vivekanandRdhakane/electrophy_2/ELECTROPHY_APP_AUDIT_AND_IMPLEMENTATION_PLAN.md

# Electrophy app audit and indexed implementation plan

Latest verification (6 November 2026): all 98 Android JVM tests passed and the debug APK was built. Following commit e5858c3 ("Keep paired Newton plot live across sample gaps"), the user verified on a Pixel 10 that 7,680 Hz dual-device streaming remains connected and responsive across packet gaps without pausing or disconnects. E003 remains partial (timing accuracy/drift and combined-mode acquisition timing remain open). Task E006 ("Repair comparator lag/correlation") completed with 8 acceptance tests in ComparatorTest.kt.

Reviewed: **11 October 2026**. Source baseline: repository commit `3262790` plus the files present during review. This is an audit and implementation specification, not a claim that the tasks below have been implemented.

## Verdict and scope

**The app is a useful prototype, but its measurements and all advertised scientific conclusions cannot currently be considered reliable.** There are confirmed data-integrity defects, a reproducible crash, incorrect numerical outputs, and physics labels that describe quantities the app does not actually measure. Fix acquisition and timekeeping before validating downstream experiment results.

Reviewed all seven application Kotlin files, all 16 experiment presets, Android permissions/build/test configuration, the firmware acquisition/command/packet paths, the bundled ST conversion driver, and relevant installed ESP-IDF v5.3.1 NimBLE source. The project context was read from `.agents/skills/electrophy/SKILL.md`. PCB electrical design was not audited.

Verification performed:

- Compiled the original `MathEngine.kt` with Kotlin 2.2.10 in a temporary JVM harness, with minimal stubs for Android-adjacent data types. Executed numerical probes of integration, FFT, STFT, statistics, autocorrelation, filter lab, and comparator; inspected derivative logic. This tests the actual engine source, not the complete Android app.
- Ran independent source-equivalent numerical checks for packet size, packing, high-g scaling, arrival-time distortion, notification counter behavior, vehicle integration, pendulum period ambiguity, free-fall triggering, and angle wrapping.
- Checked niche technical/physics claims against the primary references linked below.
- Attempted offline `:app:testDebugUnitTest :app:lintDebug :app:assembleDebug`. The first invocation could not create a Gradle cache lock under `C:\.gradle`; a retry using a writable workspace cache and installed Gradle/JDK stopped with `Error loading java.security file`. **No full Android build, lint, or test-suite pass is claimed.** The temporary workspace cache was removed.
- No Android runtime session, device flash, BLE hardware run, calibrated motion test, or throughput benchmark was performed. UX findings are from source inspection; actual layout and performance require device testing.
- Production app/firmware files were not changed. The existing modification to `workspace.code-workspace` was left alone. This document is the audit deliverable.

The skill is useful context but is not authoritative where it contradicts code or the sensor driver. In particular, its high-g sensitivity table is wrong, its CSV description overstates the current text export, and its flow-control description overstates the current implementation.

## How another AI agent should use this document

Example request:

> Implement E005 from `electrophy_2/ELECTROPHY_APP_AUDIT_AND_IMPLEMENTATION_PLAN.md`. Read its evidence, dependencies, implementation instructions, and acceptance tests. Implement only that task and necessary prerequisites. Run the relevant checks and update its status with the result.

Rules for the implementing agent:

1. Read the selected task and the shared contracts below. Read applicable repository instructions and the project skill. Re-check current source; line numbers describe this audit snapshot and will move.
2. Keep **E001–E041 stable**. Do not renumber tasks after completing or reprioritizing them. `E` IDs are distinct from the unrelated numbered ideas in `HIGH_IMPACT_FEATURES.md`.
3. Dependencies refer to completed behavior, not necessarily merged commits. If missing, report the prerequisite and implement the smallest authorized prerequisite or a clearly labeled interim fix. Never imply a downstream scientific feature is validated while its timing/acquisition prerequisites remain broken.
4. Preserve unrelated user changes. Avoid broad rewrites while fixing a local defect. Put numerical algorithms and protocol decoding into pure functions/classes where they can be tested without Compose or a BLE device.
5. App/firmware protocol changes must ship together, with a written version/layout specification and compatibility behavior. Do not silently reinterpret the existing format. An app-only deployment must identify unsupported/legacy firmware and explain unavailable measurements.
6. Add meaningful regression tests listed in the task. Do not replace real checks with tests of labels or a copy of the same faulty formula. Use known analytic signals or independently computed reference values.
7. Report exactly what was tested: JVM tests, Android build/lint, UI tests, firmware build, and physical measurements are different evidence. Never claim hardware accuracy from a passing unit test.
8. For each completed task, append a short record: status, changed files, tests/results, remaining limitations, and any follow-up IDs. Do not mark complete until its acceptance criteria are satisfied, or explicitly split an interim mitigation from final completion.
9. Keep scientific uncertainty visible: missing, stale, clipped, incomplete, and invalid results must not be represented as plausible zero values. Do not add precision or accuracy claims unsupported by measurement.
10. For ordinary verification use the project's wrapper from `Electrophy_app`: `./gradlew.bat :app:testDebugUnitTest :app:lintDebug :app:assembleDebug`. First establish a working compatible toolchain under E039. Read the ESP-IDF skill before firmware builds. No flashing is needed for most app-only fixes.

## Shared contracts and implementation order

These are design requirements, not a requirement to implement one large architecture rewrite:

- A measurement carries sensor identity, acquisition time, physical quantity/unit, applied configuration, calibration provenance, session/segment identity, and validity. Prefer integer microseconds or another documented monotonic tick unit internally; convert to plot-relative floating-point coordinates only for display.
- Keep acquired/raw data separate from calibrated and filtered data. Calibration and filtering must have explicit order and state reset rules. An experiment must say which representation it analyzes.
- Missing/off/stale sensors are absent/invalid, not zero. A repeated register value is not necessarily a new sample. Each sensor can have its own cadence.
- A capture is separate from a chart. A capture owns its boundaries, pre-event baseline, source axis/frame, parameters, and quality flags. Panning, decimation, and chart eviction must not alter saved measurement results.
- A device configuration has desired, pending, and applied states. Only applied settings describe a measurement. A rate change, reset, reconnect, or processing change must not silently mix incompatible data in one analysis.
- SI conventions: `1 g = 9.80665 m/s²`, `1 mg = 0.00980665 m/s²`, `1 mdps = 0.001 degree/s`. An accelerometer measures specific force; with a consistent body-to-world rotation, `a_world = R * f_body + g_world`. A stationary upward-facing accelerometer reads about +1 g while inertial acceleration is zero.

Recommended sequence: independently fix **E001, E005, E006** and establish **E039**; coordinate **E002–E004, E007–E010** as the acquisition/protocol foundation; then **E011–E022**; then the remaining P2 usability and interpretation work. Easy label corrections can be made early but do not count as complete scientific validation. E040 is optional expansion.

Priority meaning: **P0** silently corrupts foundational measurements; **P1** crashes, gives materially wrong results, or compromises capture reliability; **P2** completes interpretation, usability, or performance; **P3** optional expansion. P0 is a release priority here, not a claim of a safety-critical product.

## Task index

Model guidance checked **11 October 2026** for the stated **ChatGPT Plus and Google AI Pro** subscriptions. These are my engineering recommendations for the documented task scope, assuming prerequisites are complete; they are **not measured model benchmarks or guaranteed token savings**. Priority measures the consequence of a defect; complexity measures implementation difficulty. Thus E001 is P0 but still a small, well-specified fix.

**Model key:** **Luna** = GPT-6 Luna (`gpt-6-luna`); **Sol** = GPT-6.1 Sol (`gpt-6.1-sol`); **Astra** = GPT-6 Astra (`gpt-6-astra`). Use these in Work/Codex with repository and terminal access. OpenAI recommends Luna for focused tasks and Sol for complex coding at lower cost than Astra; availability depends on account/client rollout. If 6.1 Sol is absent, use the available GPT-6 Sol at the listed starting effort. [Official model guidance](https://learn.chatgpt.com/docs/models).

**Gemini key:** **Flash** and **Pro** mean the corresponding entries in the Gemini model picker, not the Google subscription name. The Gemini alternative is a substitute, not an instruction to run both providers. Google documents Low/Medium/High thinking controls; select them where exposed by your client. If your interface only offers a Pro/Thinking preset, use the corresponding available reasoning model rather than trying to set an unsupported API parameter. [Official Gemini model and thinking controls](https://support.google.com/gemini/answer/18648722?hl=en).

**Completion:** Use ✅ only when the task is fully implemented and its acceptance criteria are satisfied; otherwise leave the cell blank. Keep the task status and completion log in sync. Reconciled against source on **5 November 2026**, commit `2d5599d`: E001, E002, and E005 retain their recorded completion; E011 is partial (its earlier completion record overstates production integration). Several other tasks have partial implementations described below. Original evidence and numerical observations describe the October baseline unless explicitly updated.

| ID | Completed | Priority | Category | Task | Complexity | Recommended Codex model / effort | Gemini alternative / thinking |
|---|:---:|---|---|---|---|---|---|
| E001 | ✅ | P0 | Units | Correct high-g sensitivity conversion | Low | Luna / High | Flash / Medium |
| E002 | ✅ | P0 | Protocol | MTU-aware packets and strict decoding | High | Sol / High | Pro / High |
| E003 |  | P0 | Timing | Acquisition timestamps and explicit gaps | Very high | Astra / Medium | Pro / High |
| E004 |  | P0 | Acquisition | Fresh per-sensor samples and real synchronization | Very high | Astra / Medium | Pro / High |
| E005 | ✅ | P1 | Math | Fix median-filter crash | Low | Luna / High | Flash / Medium |
| E006 | ✅ | P1 | Math | Repair comparator lag/correlation | Medium | Sol / Medium | Pro / Medium |
| E007 | ✅ | P1 | Configuration | Atomic applied configuration and valid ODR modes | High | Sol / High | Pro / High |
| E008 | ✅ | P1 | Firmware | Propagate SPI/IMU errors | Medium | Sol / Medium | Pro / Medium |
| E009 |  | P1 | Transport | Correct flow control and loss accounting | High | Sol / High | Pro / High |
| E010 |  | P1 | Android | Reliable BLE lifecycle and operation completion | High | Sol / High | Pro / High |
| E011 |  | P1 | Capture | Separate captures, analysis intervals, and chart history | High | Sol / High | Pro / High |
| E012 |  | P1 | Math | Use actual time and align signals | High | Sol / High | Pro / High |
| E013 |  | P1 | Physics | Correct force, impulse, and SI quantities | High | Sol / High | Pro / High |
| E014 |  | P1 | Physics | Repair vehicle velocity-change experiment | Medium | Sol / Medium | Pro / Medium |
| E015 |  | P1 | Physics | Complete vector-based free-fall events | High | Sol / High | Pro / High |
| E016 |  | P1 | Physics | Measure pendulum swing period correctly | High | Sol / High | Pro / High |
| E017 |  | P1 | Attitude | Coordinate-consistent orientation estimator | Very high | Astra / High | Pro / High |
| E018 |  | P1 | Attitude | Correct plotted quantity and heading reset | Medium | Sol / Medium | Flash / Medium |
| E019 |  | P1 | Trigger | Typed trigger source and cancellable event lifecycle | High | Sol / High | Pro / High |
| E020 |  | P1 | Calibration | Validate and scope calibration | High | Sol / High | Pro / High |
| E021 |  | P1 | Recording | Reproducible structured recordings and reliable storage | High | Sol / High | Pro / High |
| E022 |  | P1 | Spectra | Correct FFT/STFT bins, amplitudes, and peak validity | High | Sol / High | Pro / High |
| E023 |  | P2 | Integration | Stable integral origins and honest detrending | Medium | Sol / Medium | Pro / Medium |
| E024 |  | P2 | Autocorrelation | Invariant period detection and useful lag range | Medium | Sol / Medium | Pro / Medium |
| E025 |  | P2 | Filters | Correct digital cutoff and response descriptions | Medium | Sol / Medium | Pro / Medium |
| E026 |  | P2 | Statistics | Correct statistical labels and plots | Medium | Sol / Medium | Pro / Medium |
| E027 |  | P2 | Derivative | Source-aware derivatives and accurate stencil labels | Medium | Sol / Medium | Pro / Medium |
| E028 |  | P2 | Physics | Correct the Newton's Third Law claim | Low | Luna / High | Flash / Low |
| E029 |  | P2 | Physics | Complete centripetal analysis | Medium | Sol / Medium | Pro / Medium |
| E030 |  | P2 | Physics | Complete elevator interpretation | Medium | Sol / Medium | Pro / Medium |
| E031 |  | P2 | Attitude UX | Remove unsupported flight/compass claims | Low–medium | Luna / High | Flash / Medium |
| E032 |  | P2 | Precision | Explicit transport resolution and range policy | High | Sol / High | Pro / High |
| E033 |  | P2 | Performance | Shared background analysis and bounded rendering | High | Sol / High | Pro / High |
| E034 |  | P2 | Charts | Trustworthy sample cursors and interval inspection | Medium | Sol / Medium | Flash / Medium |
| E035 |  | P2 | Navigation | Preserve experiment state and handle system Back | Medium | Sol / Medium | Pro / Medium |
| E036 |  | P2 | Connection UX | Device selection, recovery, and live diagnostics | Medium | Sol / Medium | Pro / Medium |
| E037 |  | P2 | Math UX | Inspectable FFT, spectrogram, and XY plots | Medium | Sol / Medium | Flash / Medium |
| E038 |  | P2 | Accessibility | Responsive controls and accessible plots | Medium | Sol / Medium | Flash / Medium |
| E039 |  | P1 | Validation | Reproducible build and scientific regression suite | High | Sol / High | Pro / High |
| E040 |  | P3 | Expansion | Saved-run browser and offline replay | Medium | Sol / Medium | Pro / Medium |
| E041 |  | P2 | Experiment UX | Guided setup, run, review, and quality feedback | Medium | Sol / Medium | Flash / Medium |

### Using the recommendations economically

- **Choose one provider per implementation.** Prefer the environment that can read the repository, edit files, and run the required tests. If using Gemini chat without those tools, provide only the relevant files and request a patch; apply and test it locally. A subscription/model name alone does not establish local execution access. Gemini model/feature availability remains subject to the plan and current limits. [Google AI plan limits](https://support.google.com/gemini/answer/16275805).
- **Do not default to Ultra for one task.** Start at the table's effort. OpenAI's controls differ by model: Luna High is a normal economical starting point, not equivalent in cost to Astra High. Max/Ultra are escalation options rather than this plan's defaults. [Reasoning-effort guidance](https://learn.chatgpt.com/docs/models).
- **Use smaller scope before more effort.** For E003/E004/E017, ask the recommended model to establish the protocol/estimator contract and tests first, then implement bounded pieces against that contract. Once settled, mechanical follow-up edits can use Sol or Luna. E039 should be split into toolchain setup, regression fixtures, and hardware qualification; no model replaces the physical checks.
- **Escalate based on evidence.** If a focused attempt plus one correction still fails a meaningful test or keeps changing its design, hand off the failing test, current diff, and short decision summary. Escalate Luna to Sol, Sol Medium to High, or unresolved Sol High architecture work to Astra Medium/High. For Gemini, escalate Flash to Pro or Medium to High. Do not keep retrying a weak approach just because its individual calls are smaller.
- **Spend a stronger review only where it matters.** After timing/acquisition/configuration work is integrated, a focused review of the shared interfaces, failure paths, and tests is more useful than re-auditing this entire document after each label edit. A successful model review does not replace the acceptance tests.
- **Read only the selected task and its dependencies.** Ask the agent to locate `### E___`, read the shared contracts and relevant source symbols, and avoid loading all 41 task bodies. Keep a short implementation handoff recording decisions, changed files, and test results. Request a concise final report, not a regenerated audit.
- **Scope qualifications:** E014 assumes the fixed-mount baseline path and completed data prerequisites; a new general 3D velocity estimator needs a separate High-effort design. E027 assumes accurate labeling of the existing derivative; adding a new validated derivative algorithm merits Sol/Pro High. E028 covers the single-sensor correction, not dual-device support. E031's inexpensive path labels the existing body-Z rate honestly and consumes existing quality state; new heading-rate mathematics or freshness infrastructure belongs to its prerequisite tasks.
- **Optimize allowance, not just visible response length.** Context, reasoning, tools, and retries affect usage; API token prices are not subscription task quotas. Use Standard speed when minimizing credit spend and check the usage dashboard rather than assuming a fixed number of tasks. No percentage saving is promised. [OpenAI subscription and credit guidance](https://learn.chatgpt.com/docs/pricing).

Suggested economical prompt:

> Implement E005 from `ELECTROPHY_APP_AUDIT_AND_IMPLEMENTATION_PLAN.md`. Read only its task body, the shared contracts, applicable repository instructions, and necessary source/dependency sections. Keep the change focused; preserve unrelated edits. Run its acceptance tests and report the changed files, actual results, and remaining limitations concisely. Do not implement other task IDs unless an essential prerequisite is identified and its scope is made explicit.

## Feature-by-feature coverage

All features depend on valid acquisition; a sound formula alone does not validate the end-to-end result.

| Existing feature | Assessment | Main tasks |
|---|---|---|
| Raw LOW/HIGH/BOTH/GYRO/ALL streaming | Packing sign convention is sound; timing, MTU, stale channels, ALL meaning, and error handling are not | E001–E004, E007–E010, E036 |
| ODR/range controls | Useful configuration coverage; displayed values can differ from hardware; 1.875 Hz request is rejected in current sensor mode | E007 |
| Pause/resume/clear | Basic actions exist; session time, callbacks, capture boundaries, and state resets are inconsistent | E003, E010, E011, E019, E035 |
| Calibration | Single-position mean subtraction is limited but useful; no motion/quality validation or device scope | E020 |
| EMA and auto-trigger | EMA recurrence is sound; cutoff label, unit mixing, and delayed trigger lifecycle need repair | E019, E025 |
| Recording/export | Records text, not reproducible timestamped CSV; charts and exports use different calibration states | E021 |
| Raw/physics charts and cursors | Useful live plots; live cursor can be an arbitrary coordinate and two cursors can refer to different axes | E011, E034, E038 |
| 3D Aeroplane Attitude | Static signs match renderer; dynamic estimation, heading claims, and degree plot are flawed | E017, E018, E031, E032 |
| Simple Pendulum | Computes Z-signal period, which can be half the actual swing period | E016 |
| Vehicle Acceleration | Uses the wrong sensor ODR, wrong units, and an unspecified frame | E014 |
| Newton's Third Law | Single-object acceleration is not an action–reaction measurement | E013, E028 |
| Free Fall | Magnitude-based helper is conceptually correct; trigger and event completeness are not | E015, E019 |
| Centripetal Acceleration | Generic peaks do not implement the advertised quantitative comparison | E029 |
| Impulse & Momentum | Integral lacks mass/SI conversion and an explicit event/baseline | E011, E013 |
| Elevator Physics | Useful qualitative trace with fixed upward mounting; interpretation and load results incomplete | E030 |
| Numerical Integration | Uniform-sample trapezoidal algorithm is sound; timebase, origin, and detrending semantics need work | E012, E023 |
| Numerical Derivative | Valid two-point central difference, not the implied higher-order stencil | E012, E027 |
| FFT Frequency Spectrum | FFT core and main window gain correction are sound; Nyquist and peak validity are wrong | E012, E022, E037 |
| Spectrogram | Windowed overlapping FFT approach is sound; scaling, axes, and recomputation need work | E022, E033, E037 |
| Statistics & Distribution | Population moments are sound on nonconstant data; labels/undefined values/plot scales need work | E026 |
| Autocorrelation | Biased normalized estimator is legitimate; detector depends on display scaling and lag range is short | E024 |
| Digital Filter Lab | Several correct basic recurrences; selecting median with default size crashes | E005, E025 |
| Signal Comparator | Pearson is correct only for aligned nonconstant data; lag search is broken and streams are not aligned | E006, E012 |
| Experiment catalog/navigation | All 16 presets are discoverable; state restoration, connection access, setup flow, and accessibility need work | E035–E038, E041 |

## Evidence reference paths

To keep tasks economical for smaller models, use these aliases. All paths are relative to `electrophy_2`:

- **MAIN**: `Electrophy_app/app/src/main/java/com/example/electrophy_app/MainActivity.kt`
- **EXP**: same directory, `ExperimentScreen.kt`
- **MODES**: same directory, `ExperimentModes.kt`
- **MATH**: same directory, `MathEngine.kt`
- **MATHUI**: same directory, `MathVisualization.kt`
- **AIR**: same directory, `Airplane3DView.kt`
- **PICKER**: same directory, `ExperimentPickerScreen.kt`
- **FW**: `esp_sensor/main/main.c`
- **ST**: `esp_sensor/main/lsm6dsv320x_reg.c`

## P0 — Measurement integrity

### E001 — Correct high-g sensitivity conversion

**Status:** [x] Complete. **Scope:** app conversion and documentation. **Dependencies:** none.

**Evidence:** MAIN:923–929 uses `0.009765 g/LSB` at ±320 g. ST:86–108 specifies `10.417 mg/LSB`, or `0.010417 g/LSB`. This underreports by about **6.259%**. The 64/128/256 g entries also differ slightly from the official driver. The project skill repeats these errors.

**Implement:** Centralize conversion by sensor/range/format. Use high-g g/LSB factors `[0.000976, 0.001952, 0.003904, 0.007808, 0.010417]`. Preserve the legacy packed12 multiplier of 16. Reject unknown range IDs. Correct the skill's table and any duplicate factors. Do not replace correct low-g/gyro factors using a guessed full-scale/32768 formula; use the manufacturer's sensitivities. [ST driver](https://github.com/STMicroelectronics/lsm6dsv320x-pid/blob/master/lsm6dsv320x_reg.c).

**Acceptance:** Packed value 600 at high-g FS code 4 becomes **100.0032 g**, not 93.744 g. Verify positive/negative/boundary values for every scale and both legacy formats against the bundled driver. Threshold display, export, and analysis must share the same conversion.

### E002 — MTU-aware packets and strict decoding

**Status:** [x] Complete. **Scope:** app + firmware. **Dependencies:** coordinate packet layout with E003/E004.

**Evidence:** FW:896–898 batches against a fixed 512-byte buffer; FW:1009–1011 only logs MTU. Full notifications can contain 509 value bytes and need ATT MTU ≥512. The installed NimBLE path (`ble_att_cmd.c:74`, `ble_att.c:408–411`) truncates oversized ATT payloads. At MTU 247, a low-g packet can still declare 111 samples but contain only 52 complete tuples. MAIN:225–226 returns zero after bit exhaustion, manufacturing apparent zero-g samples. MAIN:913 treats every unknown format as raw16; range IDs default silently.

**Implement:** Size values to `min(buffer_capacity, negotiated_ATT_MTU - 3)`. Define behavior when a full tuple plus header cannot fit; do not silently send truncated ALL tuples at MTU 23. Validate the entire frame before changing state: magic/version, allowed mode/format/ranges, sample count, and required payload bytes (`ceil(count*axes*bits/8)` plus header for the legacy layout). Explicitly define allowed padding. Make bit-reader exhaustion an error. Never feed invalid frames to calibration, triggers, timekeeping, charts, or recording. Bound text fallback accumulation; malformed binary must not become an unbounded text buffer.

**Acceptance:** All modes at MTUs 23/185/247/517, odd packed sample counts, every truncation boundary, invalid headers/IDs, and random input. No invalid input emits a sample or starts free fall. Every transmitted value fits its link capacity. Add paired firmware encoder/app decoder fixtures.

### E003 — Acquisition timestamps and explicit gaps

**Status:** [ ] Partial — v2 single-sensor FIFO timeline, counters, segments, gap handling, and overhead diagnostics implemented 5 November 2026. In-segment sample gaps are explicitly counted in diagnostics while keeping live plots and paired capture running across loss (commit `e5858c3`). Hardware timing/rate qualification and combined-mode acquisition timing remain open; see the E003 log and `esp_sensor/TIMING_PROTOCOL.md`. **Scope:** app + firmware protocol. **Dependencies:** coordinate E002/E004/E007; required by quantitative analysis.

**Evidence:** FW:127–137 has no acquisition timestamps or sample counters. MAIN:949–953 spreads samples between phone wall-clock notification times and invents +20 ms when callbacks coalesce. MAIN:908 reads but ignores sequence. MAIN:1145–1155 independently uses receipt timing for attitude. Reconnect resets the time origin without clearing chart data; resume spreads a batch across the pause.

**Implement:** Write a versioned packet specification with session/segment and configuration IDs, acquisition timestamp information, per-sensor sample counters, and validity/loss metadata. Prefer verified sensor FIFO/timestamp information; a device monotonic read timestamp needs its acquisition uncertainty documented. Define wrapping and reset behavior. Store monotonic time in `Long`/`Double`, preserving true gaps. Keep phone receipt times for transport-arrival diagnostics; absolute one-way latency additionally requires a device-to-phone clock mapping. Reset/segment on pause, reconnect, and configuration changes; never mix old/new zero-based timelines. Legacy timing must be labeled estimated and unsuitable for claims that require precision.

**Acceptance:** The same acquired samples delivered with different BLE jitter, same-millisecond bursts, and batching have identical retained timestamps and valid-interval results. Dropped samples leave explicit gaps. Phone clock changes do not alter measurements. Cover counter/timestamp wrap, pause/resume, reconnect, and long runs. No subsequent packet is stretched over a missing interval.

### E004 — Fresh per-sensor samples and real synchronization

**Status:** [ ] TODO. **Scope:** firmware acquisition and app sample model. **Dependencies:** E003, E008; coordinate E007/E009.

**Evidence:** FW:241–259 routes only the fastest selected DRDY. FW:1249 discards the returned notification count. FW:1254–1265 reads every selected channel on every wakeup, without confirming per-sensor freshness, ODR-off state, or read success. ALL at low/gyro 120 Hz and high-g 480 Hz can publish repeated low/gyro registers as 480 fresh tuples/s. Timeout wakeups and collapsed interrupts further obscure sample identity.

**Implement:** Use the part's tagged FIFO with verified configuration/timing, or read each sensor only when its data-ready state confirms a fresh sample and provide its own counter/time. Never represent an off sensor with stale values. Explicitly account for overruns/missed DRDY and rejected reads. Synchronization/resampling belongs in a declared downstream operation. Define what ALL means: the current app sometimes means accel+gyro while the wire layout includes high-g. Make source availability explicit across protocol, raw UI, and math selection.

**Acceptance:** At 120/480/120 Hz, unique per-sensor counts reflect each actual cadence. An off channel emits no valid samples. Timeout/configuration wakeups and injected SPI failures create no fake data. Validate high-rate counts and loss with FIFO counters/logic-analyzer evidence before claiming 7.68 kHz fidelity. Merely obtaining 7680 repeated values is not a pass.

## P1 — Incorrect results, crashes, and unreliable captures

### E005 — Fix median-filter crash

**Status:** [x] Complete. **Scope:** math engine + control. **Dependencies:** none.

**Evidence:** MATH:680–695 allocates `FloatArray(w)` but fills `2*(w/2)+1` interior entries. MATHUI:68 defaults to window **12**. Selecting MEDIAN with ordinary data throws `ArrayIndexOutOfBoundsException: Index 12 out of bounds for length 12` in an actual compiled-engine probe.

**Implement:** Define centered odd window sizes, normalize public engine input safely, and make the UI show the effective odd size. Deliberately handle clipped edge windows; if their population is even, specify whether the median averages the two center values. Do not just enlarge one array while leaving contradictory window labels.

**Acceptance:** Every selectable/default size, even requested sizes, short/empty input, larger-than-input windows, constants, ramps, and isolated impulses. No crash; expected medians and effective-size labels agree.

### E006 — Repair comparator lag/correlation

**Status:** [x] Complete. **Scope:** math engine/results. **Dependencies:** local algebra fix independent; final cross-sensor correctness needs E012.

**Evidence:** MATH:753–797 initializes `bestCorr=-2`, then only updates when `abs(c)>abs(bestCorr)`. Normal inputs cannot satisfy this, so lag remains zero and the clamped peak becomes −1. Actual identical sine probe: Pearson=1, peak=−1. A 10 Hz sine delayed six samples at 240 Hz produces lag=0 instead of 25 ms.

**Implement:** Correct initialization and choose/document positive-similarity versus absolute-similarity search. Preserve polarity. Normalize using the actual overlap or another documented bounded estimator; do not conceal incorrect normalization by clamping. Define delay sign in user language. Return unavailable for constant/insufficient signals. Report phase only for a justified common periodic component, not every arbitrary waveform.

**Acceptance:** Identical, inverted, constant, noisy, and positive/negative delayed deterministic broadband signals; edge overlaps; periodic examples with a stated ambiguity convention. For a nonperiodic B delayed 25 ms, report that B lags A by 25 ms within one-sample/interpolation tolerance. Aligned Pearson remains correct.

### E007 — Atomic applied configuration and valid ODR modes

**Status:** [x] Complete. **Scope:** firmware + app applied-state UI. **Dependencies:** E008; coordinate E002–E004/E010.

**Evidence:** FW:504–732 mutates hardware and shared batch state from the BLE callback while the sensor task uses them. A partly filled batch can be labeled with a newly selected scale at FW:865–869. The SPI mutex does not make a whole configuration transaction atomic. Driver returns are ignored. FW:545–547 requests 1.875 Hz with unchanged high-performance mode; ST:629–637 rejects that combination, but firmware claims it succeeded. MAIN:1318 resumes before sending the rest of the configuration.

**Implement:** Have one acquisition owner consume validated configuration requests. Finish/discard a batch using its old metadata, apply a complete configuration with driver return checks/readback and required settling, increment configuration ID, acknowledge actual settings, then restore the requested running/paused state. Changing a range while paused must not restart capture. Separate desired/pending/applied settings. Make invalid/unsupported commands explicit errors. Select the documented low-power mode for 1.875 Hz or remove that option until supported; restore appropriate modes at higher rates. A GATT write acknowledgement alone is not confirmation that the IMU accepted the configuration. [ST datasheet](https://www.st.com/resource/en/datasheet/lsm6dsv320x.pdf).

**Acceptance:** Rapid range/mode changes cannot create mixed-scale or mixed-layout batches. Driver failures and invalid commands leave a clear failed/pending state rather than false success. Verify 1.875 Hz by register state and measured cadence. Capture metadata matches the applied configuration, even during reconnect/preset changes.

### E008 — Propagate SPI/IMU errors

**Status:** [x] Complete. **Scope:** firmware readiness/error path. **Dependencies:** none.

**Evidence:** FW:347–370 discards SPI write errors and returns success. FW:382–413 discards read errors, can copy uninitialized receive data on failure, and silently clamps oversized reads. Initialization/acquisition commonly ignore driver results.

**Implement:** Propagate transport failure; release CS/mutex on every path; reject invalid lengths. Only publish fully successful measurements. Check sensor identity/configuration/readiness, expose fault counters/status, and define bounded recovery. Do not report a ready measurement device when sensor initialization failed.

**Acceptance:** Inject failures in every transaction stage, missing/wrong WHO_AM_I, oversized reads, and repeated read failure. No arbitrary values reach a packet. Resources are released and recovery/failure status is deterministic.

### E009 — Correct flow control and loss accounting

**Status:** [ ] TODO. **Scope:** firmware transport + app diagnostics. **Dependencies:** E003/E004.

**Evidence:** FW:810–816 increments `s_notify_in_flight` after `ble_gatts_notify_custom`; FW:1013–1016 decrements in `BLE_GAP_EVENT_NOTIFY_TX`. Installed IDF 5.3.1 NimBLE `ble_gattc.c:4468–4473` dispatches that event synchronously before returning, for a transmission attempt. Sequential success therefore leaves the count around one, not the claimed queue occupancy. Some dropped batches never advance sequence; app ignores sequence anyway.

**Implement:** Use a bounded acquisition-to-transport queue, explicit overflow policy, actual return-code handling, and pacing based on verified SDK semantics. Do not call notification-attempt callbacks over-air or application delivery acknowledgements. If reliable capture delivery is required, design application credits/acknowledgements or capture-then-transfer. Count all acquisition/queue/transport losses using sample identity, independently of successful packet numbering. Expose configured, acquired, and received rates separately.

Report exact loss counts where observable and explicitly unknown counts for sensor/FIFO overruns where they cannot be recovered. A counter assigned after reading registers cannot alone count unread sensor conversions.

**Acceptance:** Callback-before-return mock, allocation failures, 1M PHY, insufficient throughput, slow receiver, and disconnect during transmit. Memory remains bounded, acquisition remains responsive, no deadlock, and loss totals reconcile with sample counters.

### E010 — Reliable BLE lifecycle and operation completion

**Status:** [ ] TODO. **Scope:** Android connection owner. **Dependencies:** coordinate E007/E003.

**Evidence:** MAIN:829 declares Connected before successful CCCD completion and without requiring every characteristic. MAIN:840–855 ignores write status. MAIN:729–733/1565 treats a 250 ms timeout as completion; a late callback can advance the wrong later operation. Service discovery depends on `onMtuChanged` even when `requestMtu` fails immediately. `connectToDevice` does not retain the returned GATT until a connection callback; cancellation while connecting is incomplete. No `onCleared` cleanup or connection-generation guard exists.

**Implement:** Model scanning/connecting/discovering/subscribing/configuring/ready/error. Serialize relevant GATT operations with retained identity; check immediate start and callback status, handle fallback and bounded timeout/retry, and reconnect cleanly when state is unknown. Reject old-session callbacks and close the exact GATT instance. Retain the `BluetoothGatt` object returned by `connectGatt` immediately. Cancel scans/handlers/retries on disconnect/owner cleanup. Choose and document foreground-only capture or a properly implemented background recording service. Follow [Android BluetoothGatt contracts](https://developer.android.com/reference/android/bluetooth/BluetoothGatt).

**Acceptance:** Failed/missing CCCD, missing RX/TX, MTU-start failure, late/failed writes, scan error, connection timeout, cancellation while connecting, old disconnect callbacks after reconnect, activity rotation and final owner disposal. Never show Ready without an operational subscription/applied configuration. No leaked callbacks or GATT objects.

### E011 — Separate captures, analysis intervals, and chart history

**Status:** [ ] Partial — chart history/decimation and capture model implemented; production capture ownership and quality feedback remain incomplete (5 November 2026 review). **Scope:** data/capture model + shared chart selection. **Dependencies:** E003/E004; coordinate E019/E021.

**Evidence:** MAIN:102/1129–1133 retains 1500 points. This is about 0.195 s at 7680 Hz, 0.391 s at 3840 Hz, 3.125 s at 480 Hz, and 12.5 s at 120 Hz. Several presets request much longer windows. EXP:399–405 analyzes the entire retained list while its chart independently selects a viewport. EXP:1605/1643 re-estimates baseline from whichever first ten samples remain. Results change when old data is evicted. Promised impulse shading is absent.

**Implement:** Introduce explicit captures with start/trigger/end, fixed pre-event baseline, source/frame, applied config/calibration, and quality flags. Use a bounded duration-aware full-rate acquisition/analysis buffer distinct from plot decimation. Lift selected interval/axis above chart and analysis; feed both the same slice and draw integral/event shading. Freeze finished captures. Define supported maximum duration/rate and storage strategy rather than retaining unbounded data.

**Acceptance:** Every supported preset duration is actually available. Saved integrals remain unchanged while the live chart scrolls. Selecting either of two pulses changes shading/results together. Missing pre-trigger baseline, clipping, gap, and incomplete endpoint are visible. Chart point eviction cannot alter a captured result.

### E012 — Use actual time and align signals before math

**Status:** [ ] TODO. **Scope:** shared math input preparation. **Dependencies:** E003/E004/E011.

**Evidence:** MATH:161/201/245/415/540/714–720 uses selected ODR. Comparator pairs equal-length tails by index with no time alignment; EXP:150–155 uses only source A's ODR and coerces off to 1 Hz. Actual engine probe: constant 1 at `[0,10,30] ms` integrates to 0.02 using 100 Hz, versus 0.03 for valid irregular timestamp integration.

**Implement:** Distinguish valid irregular sampling from missing measurements. Use actual valid intervals for calculus; segment or reject gaps rather than inventing missing values. FFT/STFT/autocorrelation require a verified uniform contiguous segment or explicit validated resampling. Align comparator streams on a common time interval/grid, with anti-aliasing before downsampling. Reject duplicate/reversed time, unavailable sources, and invalid rates. Changes in rate/configuration/processing must not retroactively reinterpret old points.

**Acceptance:** Known irregular samples, explicit missing intervals, unequal-rate streams, offset starts, no overlap, ODR changes, and duplicate/reordered timestamps. A valid irregular `[0,10,30] ms` constant record integrates to 0.03; a declared loss spanning that interval is flagged according to policy. Known frequencies and delays remain correct or produce a clear unavailable result.

### E013 — Correct force, impulse, and SI quantities

**Status:** [ ] TODO. **Scope:** collision/impulse/peak analyses and quantity metadata. **Dependencies:** E001/E011/E012/E020.

**Evidence:** EXP:424–433 labels accelerometer g/mg values “Peak Force” and g·s as `∫F·dt`. EXP:1602–1612 integrates baseline-subtracted Z without mass or SI conversion. MODES:111–130/172–191 promises force, impulse, and `Δv=J/m`, but there is no mass input.

**Implement:** First correct the labels to peak specific force/acceleration and acceleration integral. For force/impulse, require positive finite mass in kg and an explicit physical model. A fixed horizontal axis along motion is a useful initial supported setup: after appropriate baseline/external-force assumptions, report `F=m*a`, `J=∫F dt`, and `Δv=∫a dt` in N, N·s, and m/s. Mass alone does not isolate a particular contact force from other forces. For general orientation, use the documented gravity/frame transformation. Retain raw g/mg as a clearly separate display. Use timestamped trapezoids over the selected capture interval, with a fixed baseline. [BIPM standard gravity](https://jcgm.bipm.org/vim/en/2.12.html), [NXP specific-force/tilt discussion](https://www.nxp.com/docs/en/application-note/AN3461.pdf).

**Acceptance:** A horizontal acceleration pulse with integral 2 m/s and mass 0.5 kg gives impulse 1 N·s. Doubling mass doubles force/impulse and leaves Δv unchanged. Equivalent low/high-g inputs give equal SI results. Missing/invalid mass leaves force unavailable. Stationary baseline-relative data yields zero integral. Do not convert an existing wrong number merely by changing its label.

### E014 — Repair vehicle velocity-change experiment

**Status:** [ ] TODO. **Scope:** vehicle preset, setup, integration. **Dependencies:** E011–E013/E020; dynamic-orientation option also needs E017.

**Evidence:** EXP:446–449 chooses `highGOdr ?: lowGOdr`, but highGOdr is non-null, even for low-g data. With low-g 120 Hz and high-g 480 Hz, integration is one quarter of its intended scale; a retained high-g `off` instead hits a 100 Hz fallback. Output is labeled `units/s` although an integral multiplies by time. MODES:92–106 selects Z without forward-axis setup and arms a 3 g deviation trigger.

**Implement:** Consume actual low-g timestamps, eliminate duplicated string/rate parsing, and report Δv in m/s. Add forward axis/sign, stationary pre-run baseline, explicit start/stop/reset, and a fixed-orientation mounting contract. Flag motion outside that model; a baseline does not remove gravity when the board rotates. A general moving-orientation option requires synchronized gyro, gravity correction, and drift handling. Remove the ordinary-driving 3 g auto-stop default; retain deliberate spike capture as a separate choice. Do not label Δv as absolute speed without initial velocity.

Low-g alone cannot reliably distinguish tilt from linear acceleration. Fixed mounting is a declared user assumption; any claimed automatic rotation check requires synchronized gyro and stated detection limits. If that check is not implemented, show the limitation and do not claim automatic rejection of tilted runs.

**Acceptance:** A baseline-corrected +1000 mg plateau with endpoints 1 s apart integrates to 9.80665 m/s, independently of retained high-g settings or prior experiments. Stationary data gives zero. Rotating a stationary board is corrected or visibly unsupported, not plausible vehicle acceleration. Re-run starts a new baseline/origin.

### E015 — Complete vector-based free-fall events

**Status:** [ ] TODO. **Scope:** shared trigger/duration detector. **Dependencies:** E002/E003/E011/E019/E020.

**Evidence:** MODES:142–148 triggers on `Z <= 100 mg` and pauses 500 ms later, but EXP:1653–1674 measures `|a| < 200 mg`. A stationary side-on board `[1000,0,0] mg` triggers despite not falling. The helper reports the longest retained low-g interval without requiring a complete start/end; a fall exceeding the delay can be presented as a completed truncated fall.

**Implement:** Use one calibrated specific-force magnitude detector for arming, triggering, and analysis. Define hysteresis, minimum duration, stationary/armed state, return/contact completion, and a maximum timeout that yields incomplete status. Use acquisition timestamps and justified threshold-crossing interpolation. Reject intervals spanning gaps/missing endpoints. Analyze acquisition data with documented filter-delay behavior. Explain near-zero accelerometer output as weightlessness/near-zero specific force, not absence of gravitational acceleration.

**Acceptance:** No stationary orientation at magnitude 1 g triggers. A complete 100 ms zero-g interval is measured within stated sampling tolerance. An 800 ms event is not silently cut to 500 ms. A low-g event at the capture boundary is in progress/incomplete. Gaps and invalid packets cannot create free fall.

### E016 — Measure pendulum swing period correctly

**Status:** [ ] TODO. **Scope:** pendulum signal/setup/estimator. **Dependencies:** E003/E011/E012.

**Evidence:** MODES:74–84 uses low-g only and suggests `T=2π√(L/g)` without a mounting model. EXP:1615–1637 finds upward mean crossings of Z. A co-rotating radial accelerometer contains `g*cos(theta) + L*thetaDot²`, terms that can repeat twice per swing. A reproduced `theta=0.2*cos(πt)` model with a 2 s swing yields a 1 s signal period. The half-period conclusion is an inference from the radial equations, not a universal correction. [Pendulum acceleration research](https://arxiv.org/pdf/1406.3867).

**Implement:** Prefer the gyro axis normal to the swing plane, with mounting/axis guidance and sufficient cycles. Add noise/prominence/hysteresis and cycle-consistency checks. If retaining accelerometer mode, call it signal period unless a specific documented mounting/model justifies conversion. Never automatically double every acceleration period. Add length from pivot to center of mass and a small-angle/simple-pendulum assumption for theoretical comparison. Distinguish physical-pendulum geometry when appropriate. [phyphox pendulum method](https://phyphox.org/wiki/index.php?title=Experiment:_Pendulum).

**Acceptance:** A 0.5 Hz angular-rate oscillation gives about 2 s. The corresponding radial signal is not reported as an unqualified 1 s swing. Flat/noise-only input, insufficient cycles, and invalid timing yield an explanatory unavailable result. Theory and measurement use the same physical period.

### E017 — Coordinate-consistent orientation estimator

**Status:** [ ] TODO. **Scope:** pure attitude estimator and input pipeline. **Dependencies:** E003/E004/E020; coordinate E032.

**Evidence:** MAIN:1145–1184 integrates host-arrival time and independent body gyro axes as Euler angle derivatives; these are not generally equivalent. It always blends accelerometer tilt, even during free fall/strong acceleration, and clamps Euler angles. Arithmetic blending across ±180° takes the wrong path: `0.97*179+0.03*(-179)=168.26°` although the orientations differ by 2°. Reset does not consistently reset estimator time/state. Static tilt signs do agree with AIR's X-right/Y-forward/Z-up convention.

**Implement:** Extract a pure normalized-quaternion or rotation-matrix estimator with documented body/world conventions. Integrate calibrated body angular rate using actual sample intervals, and synchronize accel observations by time. Reduce/disable gravity correction for invalid, saturated, low-g, or inconsistent observations; magnitude gating alone cannot reject every linear acceleration. Make correction time-constant based and independent of notification batching. Convert to Euler for display only. Reset time/history/reference coherently across sessions and explicit resets. Preserve correct static renderer signs unless a verified board mapping requires change. Yaw remains relative without an absolute heading reference. [NXP AN3461](https://www.nxp.com/docs/en/application-note/AN3461.pdf).

Convert gyro mdps to rad/s using `π/180000` before quaternion propagation. Continuity through 90° pitch applies to the quaternion/rendered orientation; Euler readouts have unavoidable singularities/branch changes and cannot be globally nonsingular.

**Acceptance:** Analytic rotations about individual and combined axes, ±180° crossings, passage through 90° pitch, stationary tilt, free fall, and acceleration disturbance. The same time-stamped motion has the same orientation under different BLE delivery schedules. Long pauses cannot integrate stale angular rate. Verify physical board axes separately from the renderer convention.

### E018 — Correct attitude plot and heading reset

**Status:** [ ] TODO. **Scope:** aircraft UI and reference ownership. **Dependencies:** E011/E017 for the final attitude-history plot; truthful relabeling is independent.

**Evidence:** EXP:314–319 selects low-g points in aircraft ALL mode; EXP:342–345 plots them with MODES:61–62 “Orientation Telemetry (deg)”. An upright ~1000 mg signal is thus plotted as ~1000 degrees. EXP:83/326–329 stores a local yaw offset while MAIN:675/1493 separately resets the underlying yaw, leaving inconsistent zeros.

**Implement:** Plot timestamped pitch/roll/relative-yaw history in degrees, or explicitly label an interim acceleration plot in mg. Own zero-heading/reference state in the estimator/ViewModel. Define Clear, Calibrate, Zero Heading, reconnect, and new-experiment behavior together. Break wrapped-yaw discontinuities or offer continuous-angle display.

**Acceptance:** Stationary upright pitch/roll plot near 0°, a known 30° pitch plots 30°, and no acceleration samples are labeled degrees. Zero Heading followed by Clear/Calibrate/reconnect produces the documented reference without a stale local offset.

### E019 — Typed trigger source and cancellable event lifecycle

**Status:** [ ] TODO. **Scope:** raw/experiment trigger engine. **Dependencies:** E003/E011; coordinate E015/E020.

**Evidence:** MAIN:408–460 has one X/Y/Z baseline and threshold. MAIN:1000–1010 passes low-g mg and high-g g or gyro mdps through that same state in combined modes, mixing quantities. Trigger evaluation occurs before calibration. Delayed pause uses an anonymous new Handler callback; disabling the trigger, Clear, changing experiment, or disconnecting does not cancel it. An old event can pause a later run. Its delay is based on receipt time, not the triggering sample.

**Implement:** Select sensor + axis/magnitude + units explicitly. Keep baseline state per selected source and processing definition. Use an event/session token and cancellable job/state machine: disarmed, warming/armed, triggered, collecting, complete/cancelled. Stop/reset must invalidate pending jobs. Capture the exact trigger acquisition time and define pre/post intervals in measurement time. Keep host-side notification delay distinct from physical event timing. Define crossing versus level triggering, hysteresis, minimum dwell, and rearm behavior. Validate finite thresholds and nonnegative bounded durations.

**Acceptance:** An mg trigger never consumes g/mdps. Calibration state matches the trigger's displayed signal. Trigger→disable, trigger→Clear, trigger→new experiment, and trigger→disconnect/reconnect cannot pause the new session. Test threshold chatter, missing baseline, batch boundaries, and event delay independently of BLE latency.

### E020 — Validate and scope calibration

**Status:** [ ] TODO. **Scope:** calibration pipeline, persistence, and UX. **Dependencies:** E004/E007/E011; no full attitude rewrite required.

**Evidence:** MAIN:599–685 averages available samples without motion/variance/sample-count validation, assumes +Z-up gravity, and sets one `isCalibrated` flag if either low-g or gyro produced samples. MAIN:688–714 persists one global set for every device. High-g has no calibration. Filtered values are passed to calibration (MAIN:996–1014/1091 onward). Disconnect during collection can leave the progress state unresolved. Calibration help promises zero drift/perfect level attitude.

**Implement:** Clearly define single-position bias calibration and supported sensors. Temporarily acquire the required channels at an applied known configuration, wait for settling, use unfiltered raw physical samples, and validate stationary magnitude/gyro variance/adequate independent counts. For accelerometer calibration require a level +Z-up fixture/setup and reject gross tilt/motion with documented tolerances; stationary gyro bias calibration can use any orientation. A single static pose cannot uniquely distinguish small tilt from horizontal bias, so disclose that ambiguity. Scope validity separately per sensor and stable physical-device identity, not its common name or potentially rotating BLE address; retain calibration method/time/configuration and invalidate appropriately. Restore the prior acquisition state. Add cancellation and timeouts. Keep high-g visibly uncalibrated unless a validated method is added; do not reuse low-g offsets. Consider six-position scale/bias calibration later, without calling the present method full calibration. Reset processing state after acceptance.

**Acceptance:** Moving, tilted, sparse, disconnected, powered-off-channel, and failed-read runs cannot produce a universal CALIBRATED badge. Device B does not inherit device A's offsets. Repeated calibration of a known synthetic bias converges to that bias without double subtraction. The UI states residual drift/limits and reports sensor-specific validity.

### E021 — Reproducible structured recordings and reliable storage

**Status:** [ ] TODO. **Scope:** recording/export pipeline. **Dependencies:** E003/E007/E011/E020.

**Evidence:** MAIN:1073–1086 formats strings and writes synchronously inside packet handling. MAIN:1501 creates `.txt` in cache; rows have no time/configuration/sample identity. Values are filtered but uncalibrated, while charts subtract calibration later. Stop/empty-share/storage-error handling is minimal. A capture cannot be independently reconstructed from the export.

**Implement:** Use an ordered bounded background writer with visible overflow/storage errors. Define a schema with session/segment, acquisition time, sensor/sample identity, raw counts or raw physical samples, physical units, applied configuration, calibration/filter provenance, and gaps/clipping. A long-format CSV per sensor plus a metadata JSON is one workable choice for asynchronous channels; never imply simultaneous tuples by filling missing channels with zero. Export processed values or enough metadata to reproduce them. Finalize/flush before sharing. Preserve recordings in durable app storage or a user-selected location; keep temporary share copies separate. Show duration/size/error/recording state across disconnect and distinguish Save from Share.

For recursive filters, raw samples and alpha alone are insufficient if recording starts mid-stream. Store processed values or the initial filter state/prehistory (or explicit capture-boundary reset) and every processing-parameter epoch needed for exact replay.

**Acceptance:** Export reproduces the declared chart/analysis inputs within serialization precision. Mode/rate changes and gaps remain visible. Low storage, write failure, stop during incoming traffic, empty recordings, and disconnection are handled explicitly. Sustained recording at each validated rate is loss-accounted and does not block BLE parsing. Update the skill's inaccurate CSV description when the new format exists.

### E022 — Correct FFT/STFT bins, amplitudes, and peak validity

**Status:** [ ] TODO. **Scope:** shared spectrum computation/results. **Dependencies:** E012 for measurement validity; pure algorithm fixes independent.

**Evidence:** MATH:244–327 excludes Nyquist (`N/2`), labels an all-zero input's first non-DC bin dominant, and calls a magnitude/distance-only second candidate a distinct local peak. MATH:433–448 STFT lacks FFT's coherent-window-gain compensation. Actual probes: 256 zeros at 256 Hz→dominant 1 Hz; `(-1)^n`→missing 128 Hz amplitude; a unit-amplitude 16 Hz Hann tone gives FFT 0.999996 but STFT 0.498045.

**Implement:** Share tested real-spectrum code returning `N/2+1` bins. Double only interior one-sided amplitudes, not DC/Nyquist. Apply matching coherent-gain normalization for amplitude STFT; if choosing PSD, explicitly change quantity/units and use the appropriate power normalization. Return absent/insignificant peak status instead of an invented frequency. Require actual local maxima and justified prominence/separation; do not report a window sidelobe as a second physical tone. Define dB reference and floor. Distinguish bin spacing, observation duration, and resolvable separation; zero-padding does not add information. [SciPy spectral analysis reference](https://docs.scipy.org/doc/scipy-1.15.2/tutorial/signal.html).

**Acceptance:** DC, zero, impulse, Nyquist, bin-centered/off-bin sine, two resolvable tones, single-tone leakage, multiple windows, and partial records. `(-1)^n` at fs=256 has amplitude 1 at 128 Hz with a rectangular window. FFT/STFT amplitudes agree under the same definition. No data/no significant tone returns unavailable, not 1 Hz.

### E039 — Reproducible build and scientific regression suite

**Status:** [ ] TODO. **Scope:** build/test infrastructure and documented hardware qualification. **Dependencies:** begin independently; expand fixtures as tasks land.

**Evidence:** The local unit test is only `assertEquals(4,2+2)`; the instrumentation test is the generated package-name check. The wrapper specifies Gradle 9.6.0 and the daemon file JDK 25, while the build uses AGP 8.5.2/Kotlin 2.1.0 and compileSdk 35. AGP 8.5 officially supports up to API 34. This is a documented compatibility mismatch, not proof that the current source cannot compile. The attempted audit build failed in local cache/JDK setup before app validation. [AGP 8.5 compatibility](https://developer.android.com/build/releases/agp-8-5-0-release-notes), [Gradle Java compatibility](https://docs.gradle.org/current/userguide/compatibility.html).

**Implement:** Establish and pin a supported AGP/Gradle/Kotlin/JDK/SDK combination, retaining required APIs; choose versions from official compatibility documentation when implementing rather than blindly upgrading everything. Document clean Windows build setup and CI. Create pure protocol/scientific fixtures covering tasks E001–E032, plus fake GATT/device callbacks and captured packet replays. Add Android UI/lifecycle tests where platform behavior matters. Treat tests as part of each fix, not a late substitute for them.

**Acceptance:** A documented fresh environment builds debug, runs meaningful unit tests and lint, and produces recorded outcomes. Firmware compiles using its documented IDF version after relevant changes. A hardware checklist records device/phone/firmware/configuration, actual unique rates/loss, negotiated MTU/PHY, clock drift, stationary noise/bias, six orientations, known angular motion, and known vibration/impact stimulus within the equipment's limits. Test at least the Android permission/API branches (pre-31, 31+, and 33+ value callbacks), different MTUs, long captures, pause/reconnect, and memory/storage pressure. Report measured tolerances, not just pass/fail. Do not claim calibrated force/impact accuracy or sustainable 7.68 kHz acquisition until the required hardware evidence exists.

## P2 — Interpretation, performance, and user experience

### E023 — Stable integral origins and honest detrending

**Status:** [ ] TODO. **Scope:** numerical integration mode. **Dependencies:** E011/E012.

**Evidence:** MATH:154–187 performs valid uniform-sample trapezoidal integration, but MATHUI:561–579/866–880/1075–1079 recomputes from zero at the moving visible window's left edge. Changing view width changes “Current Integral.” Default mean removal subtracts the full-window input mean and, for second integration, the mean velocity; it erases constant acceleration and changes assumed initial conditions.

**Implement:** Offer clearly named window integral and integral since an explicit origin/reset. Preserve the latter independently of scrolling. State initial conditions and whether the operation is AC/mean-removed. Detrending is not gravity compensation. Use quantity-aware units: integrating angular rate about a fixed known axis gives angular displacement; independently integrating body gyro components does not generally give 3D Euler attitude angles. A second gyro integral has angle×time units, not displacement. Integral of acceleration magnitude is not generally vector speed. Keep generic educational math separate from physical motion estimates.

**Acceptance:** Constant retained-DC input gives `a*t` and `a*t²/2` with zero initial conditions. View width does not alter the since-reset result. Reset establishes an explicit new origin. Mean removal gives zero for constant input and is explained. Source/unit changes invalidate or segment the old integral.

### E024 — Invariant autocorrelation period detection and useful lag range

**Status:** [ ] TODO. **Scope:** autocorrelation engine/control. **Dependencies:** E011/E012.

**Evidence:** MATH:568–617 applies a fixed `>0.15` detection threshold to raw covariance when normalization is disabled. A 0.1-amplitude 10 Hz sine yields T=0.1 s normalized but no period in raw mode. UI max lag defaults to 128 samples at 240 Hz (~0.53 s), and its largest choice 256 (~1.07 s) cannot cover many suggested pendulums. Instructions promise an exact fundamental/first major peak while code chooses a strongest candidate.

**Implement:** Detect on a normalized internal estimator regardless of display scaling. Label raw covariance with squared input units. Set lag horizon in seconds, show searchable period range, and require adequate history/cycles. Use prominence/consistency/harmonic checks and report an estimate, not an exact fundamental. Preserve the current legitimate biased estimator denominator unless intentionally changing its contract. [NIST autocorrelation definition](https://itl.nist.gov/div898/handbook/eda/section3/eda35c.htm), [NIST explanation of denominator N](https://www.itl.nist.gov/div898/handbook/eda/section3/autocopl.htm).

**Acceptance:** Unit/amplitude changes and raw/normalized display toggles do not change the period of the same valid signal. Test constant/noise-only input, 2 s periods with sufficient history, harmonics, and partial cycles. Unsupported lag ranges are visible before analysis.

### E025 — Correct digital cutoff and response descriptions

**Status:** [ ] TODO. **Scope:** raw EMA + filter lab + help text. **Dependencies:** a valid per-source sample rate; coordinate E012.

**Evidence:** MAIN:344–346 and MATH:699–701 report `alpha*fs/(2π*(1-alpha))` as EMA cutoff. That is an analog/backward-Euler parameter, not the actual digital −3 dB frequency. At fs=240 Hz, alpha=.5 displays 38.197 Hz while the actual crossing is 27.606 Hz; alpha=.9 displays 343.775 Hz above Nyquist although there is no −3 dB crossing. HP is `input-LP`; band-pass cascades have independent sliders and can imply reversed edges.

**Implement:** For `H(z)=alpha/[1-(1-alpha)z^-1]`, the LP −3 dB crossing is `fs/(2π)*acos(1-alpha²/[2*(1-alpha)])` only when the argument is valid. For `alpha > 2*(sqrt(2)-1)`, report no crossing below Nyquist. Handle alpha 0/1 explicitly. Derive/test HP cutoff against a declared gain reference and the actual cascade response; do not reuse an LP label blindly. Order requested band edges or display the true resulting response. Show per-sensor cutoff when cadences differ. Explain moving-average latency, centered median look-ahead, and that a residual is not automatically noise. Centralize duplicated cutoff logic.

**Acceptance:** Steady-state sine-sweep response matches the implemented filter across alpha values, including no-crossing cases. Test DC/step behavior, band ordering, per-sensor rates, and endpoints. UI never implies a realizable cutoff above Nyquist. A filter result preserves its declared delay/phase interpretation.

### E026 — Correct statistical labels and plots

**Status:** [ ] TODO. **Scope:** statistics result/visualization. **Dependencies:** none for local fixes; valid data input from E012.

**Evidence:** MATHUI:701–706 calls `mean±2*stddev` “Confidence Bands.” These are descriptive spread, not confidence intervals for the mean. MODES:321 asserts Gaussian thermal/MEMS noise without evidence. Histogram bars and Gaussian reference use different vertical scales (MATHUI:1537–1572). MATH:498–505 returns zero skewness/kurtosis at zero variance, where these standardized moments are undefined.

**Implement:** Label population statistics as descriptive moments, rename bands “±2 standard deviations,” and describe the normal curve as a reference model. Use one count/density scale for both bars and curve. Show unavailable for undefined moments; choose a sensible centered constant-signal histogram domain. Do not automatically replace population variance denominator N with N−1. Any future inferential confidence interval must declare assumptions, including dependence among sensor samples. [NIST confidence interval for the mean](https://www.itl.nist.gov/div898/handbook/eda/section3/eda352.htm).

**Acceptance:** `[1,2,3]` gives mean 2, population variance 2/3, RMS `sqrt(14/3)`, skewness 0, excess kurtosis −1.5. Cover empty/singleton/constant inputs, histogram count conservation, consistent bar/reference scales, and non-Gaussian data. No normality claim follows solely from a bell-shaped overlay.

### E027 — Source-aware derivatives and accurate stencil labels

**Status:** [ ] TODO. **Scope:** derivative mode/terminology. **Dependencies:** E012.

**Evidence:** MATH:218–224 uses two endpoints separated by `2*k` samples, while MATHUI:170–185 calls choices 1-step/3-step/5-step stencils. This is a wider secant, not a three-/five-point higher-order formula or smoothing fit. Labels jerk/snap do not fit gyro sources; a derivative of acceleration magnitude is not vector jerk magnitude.

**Implement:** Name the current method accurately: central difference with half-span k, declared endpoint treatment and response. Alternatively implement an independently validated multi-point/Savitzky–Golay derivative as a distinct option. Use source-specific names and units: angular acceleration/angular jerk for gyro derivatives; scalar-magnitude derivative for magnitude input. Explain noise amplification and rotating-frame/gravity limits before calling results physical jerk.

**Acceptance:** Constant, linear, quadratic, and sinusoidal inputs across widths and endpoints; valid irregular-time policy; angular and magnitude sources; correct rate/unit scaling. Wider intervals must not be advertised as an unimplemented higher-order stencil.

### E028 — Correct the Newton's Third Law claim

**Status:** [ ] TODO. **Scope:** current single-sensor experiment wording/model. **Dependencies:** E013; optional two-object work also requires synchronized captures.

**Evidence:** MODES:111–130 has one high-g stream and peak/integral features. It does not measure both objects or isolate equal-and-opposite interaction forces.

**Implement:** Rename the current mode to Collision Acceleration, or clearly describe it as a one-object measurement within a third-law lesson. Do not claim experimental verification of an action–reaction pair. Explain that different masses have different accelerations under equal-and-opposite forces. Two-device capture/import can be a separately scoped future enhancement requiring both masses, common axes/time, and external-force assumptions; do not add dual BLE merely to repair current wording.

**Acceptance:** The existing single-capture screen makes no paired-force verification claim. An educational unequal-mass example distinguishes force equality from acceleration inequality. Any future quantitative paired result requires the necessary second capture and alignment metadata.

### E029 — Complete centripetal analysis

**Status:** [ ] TODO. **Scope:** centripetal preset and inputs/results. **Dependencies:** E011–E013; synchronized angular-rate option needs E004/E012.

**Evidence:** MODES:155–169 describes `a=omega²*r`, but the current screen only returns generic historical axis peaks labeled force. No radius, radial direction, or angular-speed comparison exists.

**Implement:** Add radial axis/sign, radius from rotation axis to sensor, and a documented mounting setup. For example, horizontal radial measurement can keep gravity on a different vertical axis. Compare steady radial mean/variation with `omega²*r`; obtain synchronized gyro angular speed or explicitly user-supplied RPM and convert to rad/s. Mark supplied versus measured inputs. Handle gravity projection, transient intervals, clipping, and invalid radius. Use a selected steady interval instead of the highest historical peak.

**Acceptance:** Radius 0.1 m and angular speed 2 rad/s predicts 0.4 m/s² (~40.79 mg). Separate vertical 1 g does not contaminate radial comparison. Degrees/s and RPM inputs convert consistently. Zero/negative radius and saturated/unstable runs do not yield an unqualified agreement score.

### E030 — Complete elevator interpretation

**Status:** [ ] TODO. **Scope:** elevator setup and analysis. **Dependencies:** E011/E013/E020.

**Evidence:** MODES:194–208 asks the user to hold the device but assumes upward Z and supplies no quantitative load analysis. Tilting can resemble acceleration.

**Implement:** Guide stable +Z-up mounting or establish vertical from a stationary gravity reference with clearly limited orientation assumptions. Display signed vertical specific force/load ratio, baseline-relative vertical acceleration, and optional apparent weight `N=mass*f_up` with mass in kg. Explain that acceleration direction differs from travel direction: upward motion can include downward acceleration while braking. Flag tilt or correct it using a validated orientation pipeline.

**Acceptance:** Upward specific force 1.1 g gives load ratio 1.1 and net upward acceleration 0.980665 m/s²; 0.9 g gives negative net vertical acceleration. Mass changes apparent weight, not load ratio. Stationary tilted data is corrected or rejected under the declared setup.

### E031 — Remove unsupported flight/compass claims

**Status:** [ ] TODO. **Scope:** aircraft HUD/help/calibration wording. **Dependencies:** labels can be fixed independently; derived heading rate needs E017.

**Evidence:** AIR:185 maps pitch to CLIMB/DIVE; AIR:194–198/409–413 uses geographic compass directions for integrated relative yaw. Norm-based specific force is presented as aircraft load factor, and some help associates descent with reduced g (AIR:280/300/326–344). MAIN:1193 labels body-Z rate as turn rate. MAIN:3365–3372 promises zero drift/perfect level calibration.

**Implement:** Use nose up/down for pitch, relative heading for yaw, and remove N/E/S/W unless a real absolute reference exists. Name `|f|/g` specific-force magnitude: it is unsigned and is not signed normal load. Label body-Z angular rate accurately or derive a valid world-heading rate. Replace zero-drift guarantees with bias correction and measured residual limits. Explain that pitch does not determine climb rate. Show stale/unavailable telemetry when source quality fails, rather than plausible default 1 g/zero angles. Offer appropriate low-rate gyro range guidance through E032.

**Acceptance:** Yaw zero does not imply north. A stationary nose-up board is not labeled climbing. Negative normal acceleration is not represented as positive signed normal load. Missing/stale input and residual drift are visible. [ST tilt foundations](https://www.st.com/resource/en/application_note/an4509-tilt-measurement-using-a-lowg-3axis-accelerometer-stmicroelectronics.pdf), [NXP orientation limitations](https://www.nxp.com/docs/en/application-note/AN3461.pdf).

### E032 — Explicit transport resolution and range policy

**Status:** [ ] TODO. **Scope:** versioned transport precision and range UX. **Dependencies:** E001–E004/E009.

**Evidence:** FW:828–832 always applies signed `raw >> 4`. The existing bit packing correctly transmits that value, but it is lossy floor quantization: exhaustive 16-bit input characterization gives reconstruction error −15..0 raw counts and mean −7.5 counts across all codes. At ±2000 dps the transmitted step is 1.12°/s, larger than the 0.25°/s yaw deadband. At corrected ±320 g the step is 0.166672 g.

**Implement:** Offer raw16 at rates supported by measured transport capacity, or a new documented rounded quantizer/format with boundary saturation rules. Do not silently change legacy packed12 semantics. Preserve sensitivity/quantization metadata. Show the resolution/range tradeoff and suggest narrow ranges for small motions while detecting clipping. A ±250 dps range has 0.14°/s packed steps, but changing range alone does not prove drift-free accuracy. Preserve compatibility with older firmware.

**Acceptance:** Signed extrema, zero, ±1 count, full code range, rounding bias characterization, saturation, and mixed-version decoding. Compare small sinusoid and constant angular-rate reconstruction at supported formats/ranges. Verify throughput before making raw16 the default for high-rate modes.

### E033 — Shared background analysis and bounded rendering

**Status:** [ ] TODO. **Scope:** processing architecture/performance. **Dependencies:** E011/E012; preserve E022 result definitions.

**Evidence:** MATHUI:550–818 and 828–1066 independently extract/process the same data in composition. STFT recomputes its available history on each update. MAIN repeatedly copies whole lists and rebuilds chart datasets. Duplicate UI-thread work is confirmed; actual frame-drop severity has not been measured.

**Implement:** Compute one immutable result per operation/input/parameter version on a background dispatcher; share it between plot and result card. Cancel obsolete work and publish at a bounded UI rate. Keep ordered acquisition/recording independent of display refresh. Decimate for drawing with a peak-preserving method where impacts matter; analyze original data. Cache/incrementally update STFT on stable sample offsets. Avoid quadratic allocation churn when increasing history capacity. Prevent old-source jobs from overwriting current results.

**Acceptance:** Profile long-window, high-rate, and combined-sensor cases on a representative phone. Record frame time, CPU/memory, backlog, and received-loss counters before/after. Rapid control changes, pause/reset, and source switches stay responsive without stale results. Numeric outputs match the full-rate reference and drawing decimation does not erase reported peaks.

### E034 — Trustworthy sample cursors and interval inspection

**Status:** [ ] TODO. **Scope:** raw/physics chart interaction. **Dependencies:** E011; time precision from E003.

**Evidence:** MAIN:2801–2807 makes a live cursor from an offset touch coordinate, not a sampled trace. It is presented as point inspection. Paused highlights at MAIN:2780–2798 discard dataset identity, so C1/C2 can be different axes and still produce a slope. MAIN:2996–3018 assigns zero slope at zero Δt and omits axis-specific units. A later single tap replaces C1 although text says tap for C2. EXP contains a separate chart implementation with similar behavior.

**Implement:** Distinguish a free coordinate crosshair from sample inspection; default measurement inspection to a real sample on an explicitly selected trace. Retain source/axis/sample identity and units in cursor state. Permit slope only on the same physical quantity/trace, or explicitly describe a cross-trace difference without calling it a derivative. Show undefined at zero Δt. Add simple C1/C2 selection handles or buttons so dual measurement does not require two simultaneous fingers. Preserve cursor selections on paused captures and invalidate them coherently on new data/session. Reuse interaction logic across raw and experiment charts.

**Acceptance:** Tapping known synthetic points returns their exact sample time/value/axis within selection tolerance. Different axes cannot silently generate a same-trace slope. Zero Δt is unavailable. Two cursors can be placed with one finger/accessibility controls, and displayed Δt/Δvalue/slope units are correct. Selected interval agrees with E011 shading/results.

### E035 — Preserve experiment state and handle system Back

**Status:** [ ] TODO. **Scope:** navigation and saved UI/session state. **Dependencies:** coordinate E010/E011/E019.

**Evidence:** MAIN:1599–1600 stores routing/active experiment only in `remember`; EXP:87 likewise stores math state locally. Activity recreation returns to raw mode while the ViewModel may retain a different active experiment/configuration. EXP:103 reapplies presets and clears data on entry. There is no explicit system-Back navigation path. Raw mode inherits modified experiment settings without a clear restore action.

**Implement:** Use saved navigation/parameter state with stable experiment IDs (Navigation Compose or a small equivalent is sufficient). Make applying a preset an explicit new-run/configuration action, not an accidental consequence of composition. Define resume versus new run, manual-setting restoration, and system Back behavior. Preserve a recorded capture when leaving its screen; if Clear discards unsaved work, provide undo or a targeted save/discard choice. Distinguish display pause from acquisition pause if both are offered. Do not silently restart/reset a capture during rotation.

**Acceptance:** Rotation and process restoration recover the intended screen/settings under the documented capture policy. System Back returns through experiment→catalog→raw appropriately. Re-entering a screen does not clear a completed run or arm an old trigger. Manual raw settings can be restored deliberately.

### E036 — Device selection, recovery, and live diagnostics

**Status:** [ ] TODO. **Scope:** connection UX and stream availability. **Dependencies:** E004/E007/E009/E010.

**Evidence:** MAIN:740–747 connects to the first named `ESP_IMU`, with no device choice. MAIN:1220–1223 returns silently when Bluetooth/scanner is unavailable; scan error/recovery details are absent. The experiment screen has a status chip but no connect action. ALL is named All Sensors, decoded as nine axes, but raw UI MAIN:1696–1709/1899–1913 only presents low-g and gyro; automatic selection can leave high-g off.

**Implement:** Show a scan list with device name, identity, RSSI, and remembered last device; use service/capability filtering with a documented legacy fallback. Provide actionable Bluetooth-off, permission-denied/permanently-denied, legacy location-state, no-device, connection-failed, and reconnect states. Share connection access across raw and experiment screens. Make ALL/accel+gyro/high-g availability explicit, not contradictory. Show per-sensor configured and received unique rates, capture gaps/drops, clipping, freshness, and applied settings; put detailed MTU/PHY/protocol diagnostics in an expandable panel.

**Acceptance:** Two same-name modules are selectable and calibration follows the chosen device. Users can connect/recover from an experiment without losing setup. Permission denial and Bluetooth-off explain the next action. Off sensors are visibly unavailable and cannot produce analyses. Diagnostics distinguish requested ODR from actual delivered valid samples.

### E037 — Inspectable FFT, spectrogram, and XY plots

**Status:** [ ] TODO. **Scope:** math plot interaction/axes. **Dependencies:** E012/E022/E024.

**Evidence:** MATHUI:1217 declares `inspectedBin` but never assigns it, so the FFT inspection badge cannot activate. MATHUI:1321–1443 does not use STFT slice times for its horizontal axis and has no useful numeric time/amplitude legend; each frame scales colors to its current maximum. MATHUI:1919–2025 does not draw passed XY labels/numeric axes and uses one raw scale even for incompatible units.

**Implement:** Wire FFT selection to actual bins and show frequency/amplitude/units/window information. Draw STFT against acquisition time with frequency ticks, numeric color legend, and explicit fixed/auto scaling; inspect time/frequency/amplitude. Label both XY axes and independently scale different physical units, or normalize with a declared dimensionless convention. Preserve per-experiment controls via E035. Indicate analysis history and frequency/lag limits so users understand missing detail.

**Acceptance:** A known chirp appears at the right times/frequencies. A signal amplitude step remains comparable under fixed spectrogram scale. Selecting a known FFT bin shows its actual value. Mixed mg/mdps XY axes are correctly labeled/scaled; normalized mode is unmistakable. Touch/keyboard/TalkBack paths can reach the core inspection values.

### E038 — Responsive controls and accessible plots

**Status:** [ ] TODO. **Scope:** all screens. **Dependencies:** none for local improvements; coordinate E034–E037.

**Evidence:** PICKER uses non-wrapping configuration-chip rows. MAIN/EXP divide fixed screen space between charts and dense controls; several controls/text use 9–11 sp sizes and very short slider rows. Custom MATHUI chips lack explicit selection semantics, and Canvas charts lack equivalent accessible measurement output. These are source-indicated risks, not a completed device visual audit.

**Implement:** Test and adapt layouts for narrow phones, landscape, large font/display size, keyboard, and screen-reader use. Wrap/scroll chip groups intentionally, keep primary run/stop/connect controls reachable, and provide suitable touch targets. Add semantic labels/selected states for custom controls. Do not use color alone for axes/connection/quality. Supply text/table alternatives for essential plot values and a full-screen chart option. Move shared visible text to resources and use locale-aware formatting while keeping exported numeric schema locale-stable.

**Acceptance:** Device/emulator screenshots and interaction checks at compact width and enlarged fonts; no clipped critical controls or hidden result errors. TalkBack announces operation/source/selection/value/status, axes are identifiable without color, and run/stop/inspect are usable with accessible input. Validate light/dark contrast only if both themes are supported.

### E041 — Guided setup, run, review, and quality feedback

**Status:** [ ] TODO. **Scope:** experiment workflow UX. **Dependencies:** E007/E011 and the selected experiment's correctness tasks.

**Evidence:** EXP applies a preset immediately on entry, hides setup instructions by default, and mixes live controls/results. Physics parameters such as mass, axis, radius, and capture completeness are missing from the current workflow. The catalog title “Physics Experiments” also includes eight mathematics modes.

**Implement:** Use a concise setup→ready→run→review flow. Show required mounting/axis, physical assumptions, parameters with units, active calibrated sources, applied range/rate, and readiness before arming. Start a new capture deliberately. During capture show elapsed time and event state; after capture show the selected interval, quality flags, calculation definition, result units, and save/repeat actions. Make expected qualitative behavior and theory-versus-measurement comparison available without crowding live controls. Rename catalog appropriately and add lightweight category/search/favorites only where they improve discovery. Parameter validation belongs next to its input.

**Acceptance:** A new user can complete each of the eight physics experiments without guessing orientation, mass, axis, or what constitutes a completed run. Incomplete/gapped/clipped/uncalibrated conditions explain which result is affected. Repeat uses a fresh baseline and preserves the previous saved capture. All math modes disclose source, interval, processing parameters, and units.

## P3 — Optional expansion after correctness

### E040 — Saved-run browser and offline replay

**Status:** [ ] TODO. **Scope:** optional app feature. **Dependencies:** E011/E012/E021/E035.

**Evidence/opportunity:** Current files are shared text dumps with no import/replay. `HIGH_IMPACT_FEATURES.md` idea 1 already proposes structured export/replay; this task makes it a bounded follow-on to reliable captures, not a duplicate competing data format.

**Implement:** List named captures with experiment/device/time/configuration/quality; open a saved run, scrub/replay, and run supported math analyses without hardware. Preserve original data and processing provenance; edited analysis settings create a new derived result. Use E021's schema. Validate versions/units/counts/size when importing. Keep original and derived timestamps intact; replay speed affects display, not analysis time.

**Acceptance:** A saved deterministic capture produces the same result online and offline, at every replay speed. Interrupted/incompatible/corrupt files fail with useful messages. Users can rename/share/delete their own selected runs without deleting unrelated recordings. Memory remains bounded on large imports.

## Reproduced numerical evidence

These are audit checks, not substitutes for permanent regression tests or hardware qualification.

| Check | Observed current behavior | Correct expectation/interpretation | Task |
|---|---|---|---|
| High-g packed code 600, FS=320 g | 93.744 g | 100.0032 g using official sensitivity | E001 |
| Fixed full low-g packet at MTU 247 | Header can declare 111 tuples; only 52 complete tuples fit; decoder invents zeros | Size to MTU and reject incomplete frames | E002 |
| Coalesced packet arrival times | Artificial +20 ms increments | Acquisition times independent of delivery | E003 |
| Median filter, default window 12, ramp | JVM array-index exception | Defined median, no crash | E005 |
| Identical 10 Hz sinusoids | Pearson 1, peak cross-correlation −1 | Consistent positive match at zero lag | E006 |
| 10 Hz sine delayed six samples at 240 Hz | Lag 0, phase 0 | Delay/phase according to a declared periodic convention; use broadband tests for unique lag | E006 |
| Constant 1 at valid times 0/10/30 ms | Integral 0.02 at supplied 100 Hz | 0.03 using the actual valid intervals | E012 |
| 120 samples of +1000 mg with low-g 120/high-g 480 Hz | Legacy rectangle sum 250 “units/s” | SI Δv depends on actual duration; a 1 s plateau is 9.80665 m/s | E014 |
| Stationary side-on `[1000,0,0] mg` | Z-based free-fall trigger fires | Magnitude near 1 g rejects free fall | E015 |
| Radial signal of a 2 s pendulum model | Mean-crossing signal period 1 s | Do not equate radial signal period with full swing without model | E016 |
| Blend +179° with −179°, alpha=.97 | 168.26° | Continuous orientation across the wrap | E017 |
| 256 zeros, fs=256 Hz | Dominant frequency 1 Hz, amplitude 0 | No significant peak | E022 |
| `(-1)^n`, N=256, fs=256, rectangular window | Spectrum stops at 127 Hz; missing tone | Nyquist bin 128 Hz, amplitude 1 | E022 |
| Unit 16 Hz Hann sine, N=256, fs=256 Hz | FFT 0.999996; STFT 0.498045 | Matching amplitude normalization | E022 |
| 0.1-amplitude 10 Hz autocorrelation, 480 samples, fs=240 Hz, maxLag=128 | T=.1 s normalized, no period raw | Display scaling cannot change detection | E024 |
| EMA alpha=.5, fs=240 Hz | Label 38.197 Hz | Actual LP −3 dB crossing 27.606 Hz | E025 |
| EMA alpha=.9, fs=240 Hz | Label 343.775 Hz | No −3 dB crossing below Nyquist | E025 |
| Signed packed12 reconstruction across all 65536 input codes | Errors −15..0 raw LSB; average −7.5 | Existing floor quantization is lossy, not a sign-unpacking bug | E032 |

## Correct foundations to preserve

- The packed12 MSB-first ordering and sign extension agree between firmware and app; multiplying by 16 correctly reconstructs the retained upper bits. Precision loss and incorrect high-g sensitivity are separate issues.
- Low-g and gyro sensitivities match the official bundled driver.
- The radix-2 FFT matched a direct DFT in the JVM probe (maximum tested error approximately `8.1e-7`). Standard window formulas and FFT coherent-gain compensation are useful existing foundations.
- Population mean/variance, RMS, skewness, and excess kurtosis are correct for ordinary nonconstant input. N is a valid denominator for the current descriptive population variance and biased autocorrelation contracts.
- The numerical trapezoidal integrator and centered two-point derivative are valid under their uniform-sampling assumptions. Fix timing and interpretation instead of replacing correct arithmetic without evidence.
- Axis peak selection correctly returns the signed sample with largest absolute magnitude. A signed negative peak is not itself a bug.
- Mean-crossing interpolation works for a clean suitable periodic signal; the pendulum problem is the physical signal/model and robustness, not an automatic need to swap crossing signs.
- Vector magnitude is appropriate for detecting near-zero specific force in free fall and for displaying unsigned g magnitude. It is not signed normal load.
- Static accel tilt signs match the software renderer's declared axes; physical board mounting still needs verification.
- Firmware already enables BDU and serializes individual SPI access. The bundled gyro full-scale setter already powers down/restores the gyro; do not file that as an additional missing step without new evidence.
- `g_send_interval_us` is unused; its 1 ms floor does not prove a 1 kHz acquisition ceiling. High-rate fidelity must be measured by unique samples and losses.

## Boundaries and roadmap reconciliation

`HIGH_IMPACT_FEATURES.md` is a wishlist, not an implementation/validation record. Keep it as product ideas; use this file for the current corrective work. Its feature 1 overlaps E021/E040, and feature 2 could later extend E028. Industrial severity grading, certification, biomechanical conclusions, and other expansions need their own requirements and validation; do not inherit those claims from existing generic signal-processing code.

Physical tests still needed after code fixes include sensor axis/mount verification, noise and bias across ranges, calibration repeatability, FIFO timestamp behavior, achievable unique acquisition rates, radio/phone-dependent throughput, packet loss, clipping, sensor bandwidth/aliasing, and comparison against a characterized motion/vibration reference. The present audit cannot certify absolute measurement accuracy from source code.

## Source reconciliation — 5 November 2026

Reviewed current app/firmware source and repository history through `2d5599d`. Compared later changes with the task contracts, including changes after `47f405d` (the recorded E011 implementation). This is a source review: existing test source was inspected, but tests, Android/firmware builds, UI sessions, and hardware measurements were **not rerun**. Earlier log test results remain historical claims, not new verification. No additional whole task meets enough of its acceptance contract to add a completion tick in this review.

### Implemented improvements missing from the task statuses

Paths below are relative to `electrophy_2/`; app filenames refer to `Electrophy_app/app/src/main/java/com/example/electrophy_app/`.

| Task | Already implemented in current source | Still required for full completion |
|---|---|---|
| E003 | `MainActivity.kt::processBinaryPacket` uses monotonic elapsed time and replaces the old artificial 20 ms packet increment with a 0.001 ms ordering floor. `ReceiveRateMeter` consumes packet sequences. | Sample times are still interpolated from BLE arrival times, not acquisition times. The AA55 header has no acquisition timestamp/session/sample identity; sequence gaps do not become analysis quality flags. |
| E004 | `esp_sensor/main/main.c::imu_fifo_sync/imu_fifo_drain` uses tagged hardware FIFO entries for LOW_ACC, HIGH_ACC, and ONLY_GYRO; handles read failures and logs FIFO overrun observations. Commit `a84e795`. | BOTH_ACC/ALL retain direct-register tuples without per-sensor freshness/synchronization. FIFO timestamp batching is explicitly disabled. Validate unique cadence/loss on hardware; an overrun observation is not an exact lost-sample count. |
| E007 | A recursive SPI mutex covers complete configuration/read operations; stream-generation changes invalidate old batches and queued packets. Commit `d0dde0d`. | Driver configuration failures still do not gate updates to `g_*` settings; app setters immediately update displayed settings without applied-state acknowledgement. The 1.875 Hz command still requests an unchanged operating mode. Register/cadence verification and configuration provenance remain missing. |
| E008 | `platform_write` returns SPI errors; `platform_read` rejects reads over 32 bytes and copies receive data only on success. Normal BLE direct acquisition rejects a tuple when any driver read fails; FIFO reads count errors. Wrong WHO_AM_I stops the sensor task; commands check `sensor_ready`. | Initialization and configuration still ignore many driver return values, and the console-only acquisition branch ignores read failures. Add transaction-stage fault injection and deterministic readiness/recovery verification. This substantially fixes the original SPI defects but does not complete the task. |
| E009 | Replaced the NOTIFY_TX in-flight counter with a bounded 16-packet retry queue, handling ENOMEM/EAGAIN/EBUSY and permanent errors. Added acquired/submitted/pending/overflow/discarded counters, decoded receive rates/sequence gaps, and explicit submission-versus-delivery wording. `imu_transport.h`, `StreamDiagnostics.kt`, `StreamDiagnosticsPanel.kt`, `STREAM_DIAGNOSTICS.md`; queue/packing and diagnostics test sources exist. Commit `d0dde0d`. | No end-to-end sample identities or analysis-visible gaps; exact sensor losses remain unknown. Queue tests do not establish real allocation/disconnect/slow-receiver behavior. Complete reconciliation and the required throughput/failure qualification. |
| E010 | Serialized GATT writes, timeout/retry handling, `onCleared` cleanup, and an address check on connection callbacks exist. | Connected is still set before successful CCCD completion and without requiring RX/TX/CCCD; write callbacks advance regardless of status. Timeouts advance the queue without proving completion. Address checks do not distinguish successive GATT sessions for the same device. Scan errors, connection deadlines, and full operation ownership remain incomplete. |
| E028 | The catalog now describes two strikers' **accelerations**, removes this preset's force/impulse flags, and routes to `NewtonsThirdLawScreen.kt` with two BLE owners. Shared axis selection, baseline zeroing, dual threshold coincidence, receive-gap display, and impact-peak alignment exist. Commits `e532e8a`, `2d5599d`. | The original single-device evidence is historical. The replacement is an acceleration comparison: there are no mass inputs, synchronized acquisition clocks/captures, or paired-force calculation. Aligning each impact peak to zero does not establish simultaneity. Add the unequal-mass explanation and explicitly qualify what this lesson can demonstrate; do not treat dual BLE as validation of equal-and-opposite force. |
| E033 | Peak-preserving chart decimation and bounded buffers remain implemented; terminal output is throttled. | Math still runs in Compose paths without the proposed shared background analysis/cache. Representative-phone frame time, backlog, memory, and full-rate numerical equivalence are not established. |
| E036 | Unique device names, discovered-device selection, two device slots, delivered receive rates, RSSI/PHY/MTU/interval/queue diagnostics, and battery display exist. Commit `d02e6c7` plus diagnostics changes. | Calibration still uses shared `sensor_calibration` preferences rather than device identity. Experiment instructions still direct connection through Raw Data. Off/stale-channel analysis gating, applied configuration, and complete recovery flows remain open. |
| E039 | More permanent regression sources exist: conversion, decoder, median, capture/decimation/range limits, stream diagnostics, battery, and native C transport/packing. Hardware measurement instructions exist in `esp_sensor/STREAM_DIAGNOSTICS.md`. | A documented reproducible build/lint result and the broader scientific fixtures/hardware qualification required by E039 are not established by this review. A checklist is not a measured result. |

### Correction to the existing E011 completion claim

The earlier log correctly records useful components, but **E011 is partial**, so its tick has been removed. `MeasurementCapture` and `DurationBoundedBuffer.captureInterval` are referenced only inside `CaptureModels.kt` in production source; experiment screens do not consume saved captures. `ExperimentScreen.kt` still computes metrics from the visible chart window, and callers of `calculateImpulse` / `estimateVelocityChange` omit `fixedBaseline`. Thus the baseline/result can change with the window. Quality enums exist, but clipping/gap quality is not wired through capture creation and result display. Full selected-interval shading/results and saved-capture ownership remain to be integrated.

The 50,000-point cap also limits retained history to about **6.51 seconds at 7680 samples/s**, so the duration buffer cannot guarantee a 30-second viewport at every supported rate. Existing 35-second retention tests cover up to 1000 Hz. Drawn range-limit lines added in `3d8eb0b` are useful, but they do not detect and propagate a capture's clipping validity (E011/E032).

### Remaining unchanged defects and historical-record caveat

- E006 still initializes `bestCorr = -2f` and compares absolute magnitudes; the documented comparator failure remains.
- E012/E013/E014 remain open: integration still uses nominal ODR, force/impulse labels still operate on acceleration without mass, and vehicle results still use the high-G-first rate selection and `units/s` label.
- E018 still plots sensor data under attitude labels and keeps a local `yawOffset`; E019 still mixes trigger sources in combined modes and posts an uncancelled delayed pause on a new Handler.
- E021 still writes formatted text synchronously on receipt, without reproducible sample timestamps/configuration. E022 still omits the Nyquist bin; E025 still uses the approximate analog cutoff formula. E035 still uses `remember` screen state without system Back handling/restoration. These are not resolved by newer connection or chart features.
- E002's old log says text accumulation is bounded to 4096 characters. Current `appendLog` has no such bound: a stream with no newline can grow `pendingData` indefinitely. The strict binary decoder/MTU implementation remains, but restore that recorded hardening or track it as a regression; this review does not silently reaffirm every statement in the old completion log.
- Battery/power management and assembly-test modes are additional work outside the original 41 task contracts. Their presence does not imply scientific validation tasks are complete.

## Completion log template

For each implemented task append:

```text
Task: E___
Status: Complete / Interim mitigation / Blocked prerequisite
Changed files:
Behavior changed:
Regression tests and actual results:
Android/firmware build result:
Hardware/UI verification performed (or explicitly not performed):
Remaining limitations and follow-up task IDs:
```

### Log entries

```text
Task: Newton 7,680 Hz paired live plot across gaps and GATT write serialization
Date: 2026-11-06
Commit: e5858c3
Status: Device disconnect loop at 7,680 Hz resolved; E003 remains Partial
Evidence:
- User reported two devices repeatedly connected and disconnected in Newton's third law
  at 7,680 Hz on a Pixel 10. Missing packet intervals interrupted the paired plot; a
  subsequent pause GATT write timed out, prompting the app to disconnect the device.
- User requested keeping 7,680 Hz as default and explicitly removing the requirement to
  pause when samples are missing.
Cause:
- In-segment packet gaps triggered paired-capture interruption and UI freezes, followed
  by automatic pause commands to both devices.
- Concurrent configuration and pause commands to dual devices could collide in the Android
  BLE stack, causing synchronous write refusals (started=false) or timeout disconnects.
Changes:
- Retain 7,680 Hz as default ODR.
- In-segment missing samples (gaps) are counted in diagnostics (`timingGapSamples`, status)
  and retain discontinuous device timestamps, but do NOT stop the live plot or interrupt
  the paired run.
- Segment restarts and brief delivery stalls re-arm baseline/armed state without disconnecting.
- MainActivity: serializes configuration writes across devices (`_isConfiguring`), and gates
  auto-trigger callbacks during configuration.
- GattWriteGate: adds `retryRefusedCommand` and `retryReady`, allowing up to three immediate
  retries when Android synchronously refuses a write start before failing the session.
  Accepted writes continue to require single-flight callback completion.
- PairedCollisionController & NewtonsThirdLawScreen: frozen peak bounds survive history resets;
  continuous stream keeps flowing across missing packets.
Verification:
- Added CollisionChartDataTest, GattWriteGateTest, and PairedCollisionControllerTest fixtures.
- All 90 Android JVM unit tests passed; debug APK built successfully.
- Physical device retest on Pixel 10 by user: confirmed streaming and paired capture at
  7,680 Hz no longer disconnects or stalls ("it is resolved now").
Remaining limitations:
- E003 remains partial: physical hardware qualification of timing accuracy, oscillator drift
  over long captures, and combined-mode (BOTH_ACC / ALL) acquisition timing remain open.
```

```text
Task: E010 stalled GATT command / retry storm follow-up
Date: 2026-11-06
Evidence:
- User Logcat shows high_acc started=false every ~60 ms, then characteristic-write
  status 133 and a real GATT state disconnect (status 22). No firmware reset cause
  was supplied; radio/peripheral failure is not inferred from these codes alone.
Cause in app queue:
- The 250 ms command / 350 ms descriptor timeout released an unfinished GATT
  operation and advanced commands despite Android potentially still being busy.
- Failed write starts were unconditionally requeued after 60 ms; callback status
  was ignored, and Connected could be shown before subscription completed.
Changes:
- GattWriteGate serializes subscription/command completion; failure blocks reuse
  until the connection is reset. A timeout never counts as successful completion.
- Ten-second callback deadline; refusal/failure/missing completion stops that
  session once with a reconnect message. No repeated started=false retry loop.
- Only a successful CCCD completion starts configuration and marks Connected.
  Validate required RX/TX/CCCD and actual subscription initiation.
- Pending commands and teardown carry session identity; command queue bounded
  to 128 entries. Preserve per-device callback ownership and guard failed sessions.
- Newton initial streaming no longer sends an extra pause/resume cycle. Explicit
  operator Pause/Resume remains. Real control failures show a short actionable error.
- Include device and numeric write-start status in existing command logs.
Verification:
- Added five GattWriteGate JVM fixtures for delayed/missing callbacks, subscription
  ordering, status/refusal failure, blocked retries, and independent device owners.
- Physical Android/BLE retest required; no firmware change or link-stability claim.
- E010 overall remains incomplete (full lifecycle/API/hardware qualification and
  applied-device-configuration acknowledgement are still separate work).
```

```text
Task: Newton startup callback crash / E010 session ownership
Date: 2026-11-06
Status: Reported notification exception fixed; real link-disconnect cause unconfirmed
Evidence:
- User Logcat shows repeated NullPointerException in PairedCollisionController.accept
  line 201, delivered through Android's BLE notification callback. It does not show
  an actual GATT-disconnect status or firmware disconnect reason.
Cause and fix:
- Manual-zero compatibility initializes both zero offsets before both devices have
  samples. The readiness predicate wrongly assumed a non-null zero also implied a
  non-null last timestamp. Device 2 arriving first, or device 1 accumulating enough
  history before device 2, dereferenced a null timestamp.
- Readiness now checks each stream's actual first/last timestamps before comparing
  history duration. Both arrival orders and startup segment resets are tested.
- Separate hardening: each connection gets a generation-bound callback; stale
  callbacks/queued GATT completions/retries cannot operate on a later session at
  the same device address. Disconnect/disposal invalidate the owner; replacement
  connections release the previous GATT. Lifecycle mutations are serialized.
- Added low-frequency ElectrophyBLE GATT state logs with device/session/status;
  no per-sample logging or UI debug footer. Two similar command lines can be the
  expected one-per-device configuration writes, not a reconnect loop.
Verification:
- Android testDebugUnitTest passed: 77 tests, zero failures/errors; assembleDebug passed.
- JVM tests cover the reported asymmetric-arrival crash and stale-session ownership;
  actual Android BLE/firmware disconnect behavior still requires device retesting.
- No firmware change. E010's broader readiness/operation-completion work remains open.
```

```text
Task: Newton threshold-pause / peak-alignment regression fix
Date: 2026-11-06
Status: Original automatic threshold interaction restored; physical retest pending
Cause:
- Restoring Pause/Resume buttons alone left controller baseline/prehistory readiness
  gates in the automatic trigger path; VM threshold callbacks were still no-ops.
- Alignment/zoom required a completed controller snapshot, so blocked thresholding
  or an early manual pause prevented the earlier peak/zoom behavior too.
Fix:
- Restore actual High-G threshold callbacks, a shared three-second coincidence
  window, and the configured delayed pause on both devices. On both-paused state,
  freeze current continuous data, independently align displayed-signal peaks, and
  zoom to 10 ms. No baseline/prehistory gate blocks these threshold callbacks.
- Use operator zero offsets (default zero) instead of relearning an impact as a
  stationary baseline. Manual Pause also works before readiness conditions.
- Use the same signed planar signal for anchor selection and plotting, and search
  recent retained history up to ten seconds, as the earlier screen did.
- Retain gap/disconnect/configuration invalidation and old-callback/segment guards.
- The production pause delay is phone-timed again, as explicitly preferred by the
  user; v2 still supplies sample timestamps for plotting. Sample-exact endpoints
  and synchronized clocks are not claimed. This supersedes earlier workflow logs.
Tests:
- Added fixtures for immediate threshold callbacks, one-time paired pause scheduling,
  expired/old crossing isolation, and perpendicular-motion peak-anchor regression.
- testDebugUnitTest passed: 73 tests, zero failures/errors. assembleDebug passed.
- Hardware/UI threshold-pause/alignment/zoom retest still required; no firmware change.
```

```text
Task: Newton paired-capture workflow adjustment
Date: 2026-11-05
Status: Pause/Resume user flow restored following device feedback
Behavior:
- Restore Pause/Resume and automatic streaming on connection; remove New run/Ready
  workflow from the main screen. Keep Clear and Zero both sensors controls.
- Manual Pause freezes both current continuous windows without claiming a completed
  automatic event; auto-trigger still uses paired sample-time endpoints.
- Keep shared interruption, old-segment rejection, fresh-baseline, and cancellation
  protections. Show interruption errors only; previous capture recall lives inside
  the expanded Instructions & Setup card.
- Earlier paired-controller log describes the initial UI, superseded by this entry.
Verification:
- Android testDebugUnitTest passed: 69 tests, zero failures/errors; assembleDebug passed.
- Manual-pause fixtures cover continuous-window freezing and rejection of interrupted
  pairs. No new physical-device/UI verification performed after this adjustment.
```

```text
Task: E011 / E019 / E028 paired Newton capture follow-up
Date: 2026-11-05
Status: Paired run ownership implemented; broader tasks remain partial/open
Changed files:
- Electrophy_app: PairedCollisionController.kt, NewtonsThirdLawScreen.kt,
  MainActivity.kt, ExperimentModes.kt, PairedCollisionControllerTest.kt
- Electrophy_app/PAIRED_COLLISION_CAPTURE.md
Behavior:
- One shared state machine owns baseline/armed/capturing/complete/interrupted state.
- Both devices require fresh contiguous v2 High-G intervals. Gaps, invalid data,
  disconnects, configuration changes, and timeouts invalidate an unfinished pair.
- Fresh runs cancel old triggers, request new stream segments, reject known old
  queued segments, and collect new stationary baselines/prehistory before arming.
- Event endpoints use per-device sample timestamps. Both intervals must complete
  before creating an immutable pair and pausing; a single paused device cannot
  cause old live peaks to be paired. Cross-device peak alignment remains explicitly
  a display comparison, not clock synchronization or force verification.
- Preserve the latest completed pair (including baselines and device identities)
  through Clear, later failures, live eviction, and navigation while ViewModels live.
- Atomic trigger-generation cancellation prevents delayed callbacks surviving a
  restart. Lifecycle effects check run identity before pausing a newly started run.
- Clear/New run/Stop and previous-capture recall replace ambiguous paired Resume.
Verification and limits:
- Dedicated deterministic JVM fixtures cover paired completion/interruption,
  missing/reordered data, boot/segment startup/reset, saved-pair preservation,
  unmatched/stale stream expiry, baseline checks, history limits, old queued data,
  and sample-time boundary invariance under different deliveries.
- testDebugUnitTest passed: 67 total tests, including 12 paired-controller tests,
  zero failures/errors. assembleDebug passed; rebuilt APK available.
- Hardware/UI verification not performed. Follow PAIRED_COLLISION_CAPTURE.md.
- No firmware changes. No synchronized clocks, mass/force computation, persistent
  saved-run browser, or general-purpose E011/E019 completion is claimed.
```

```text
Task: E003 verification cleanup
Date: 2026-11-05
Status: v2 selected for normal use; temporary comparison code removed
User-provided measurements:
- Single-device Android OFF/ON/OFF run: approximately 7668 / 7670 / 7667
  received samples/s over 42.2 / 82.5 / 42.2 seconds.
- v2 stayed in segment 43 with zero detected missing samples/rejected frames;
  approximately 37.18 kB/s versus 35.16-35.17 kB/s legacy (about 5.7% overhead).
- Earlier firmware excerpts included a separate overflow/retry episode. These
  observations do not establish zero loss under all conditions or timing accuracy.
Changed files/behavior:
- MainActivity.kt always negotiates proto2. Removed the comparison switch/state,
  E003 Logcat summaries, and per-packet comparison bookkeeping.
- Firmware main.c removes proto1 switching and TIMING overhead summaries/state.
  Keep proto2 negotiation and legacy compatibility for old apps/firmware and
  combined modes. Preserve actual timing identities, gap detection, and validity.
- Preserve regression tests and pre-existing opt-in STREAM/FIFO/PERF diagnostics.
- Removed the isolated temporary e003-fw-compat build project from workspace build/.
- Updated TIMING_PROTOCOL.md and STREAM_DIAGNOSTICS.md; old comparison instructions
  and log descriptions in earlier completion entries below are historical.
Verification:
- ESP-IDF 6.1.0 build passed; app image 0xa5580 bytes (35% partition free).
- Android testDebugUnitTest (55 tests, zero failures/errors) and assembleDebug passed.
Limitations:
- E003 stays partial: clock accuracy/drift and combined-mode timing remain open.
  Hardware measurements above are user-provided; no new device run or flash here.
```

```text
Task: E003 / E039 ESP-IDF 6.1 follow-up
Date: 2026-11-05
Status: ESP-IDF 6.1.0 production build verified; hardware qualification pending
Changed files:
- esp_sensor/main/main.c, .vscode/settings.json, .gitignore
- esp_sensor/README.md, TIMING_PROTOCOL.md
Findings and fixes:
- Existing build cache still referenced IDF 5.1 compiler/Python paths. Set the
  laptop's VS Code build path to build-idf61; retain old build artifacts separately.
- Fresh 6.1 compilation exposed a linker error for ble_gattc_exchange_mtu:
  peripheral-only 6.1 configuration disables GATT-client support. Guard that optional
  call with MYNEWT_VAL(BLE_GATTC); Android still initiates MTU negotiation and the
  server responds, with negotiated limits tracked by the existing MTU event.
Verification:
- idf.py -B build-idf61 build passed on the installed ESP-IDF 6.1.0/GCC 15.2 toolchain.
- App and custom power-hold bootloader linked. App image 0xa5960 bytes, 35% free;
  bootloader image 0x53a0 bytes, 35% free.
- No Android changes/tests required for this firmware/configuration-only fix.
- No flash or hardware/throughput verification. Compare timing overhead using the
  same SDK version on both legacy and v2 runs.
```

```text
Task: E003 / E039 build follow-up
Date: 2026-11-05
Status: Firmware build blocker resolved; hardware qualification still pending
Changed files:
- esp_sensor/main/CMakeLists.txt, main/battery_monitor.c, main/main.c
- esp_sensor/README.md, TIMING_PROTOCOL.md, tests/test_imu_transport.c
- Android timing decoder/routing/fixtures and timing protocol documentation
Behavior changed:
- IDF 5.1 uses the combined driver component; newer SDKs retain split drivers.
- Battery channel/calibration share the SDK-appropriate attenuation name.
- Compile optional NimBLE data-length-change diagnostics only when supported;
  unavailable TX data length remains unknown, not a claimed measurement.
- Corrected my timing packet identifier collision with battery telemetry:
  timing v2 is AA58, battery remains AA57, diagnostics remain AA56.
- Added regression assertions that timing frames cannot route as battery/diagnostics.
Verification:
- Production idf.py build passed on installed ESP-IDF 5.1.2, ESP32-C3, BLE enabled.
- build/esp_sensor.bin generated: 0x8f650 bytes, 44% app partition free.
- Corrected Android testDebugUnitTest and assembleDebug passed (55 tests);
  timing-frame routing assertions now prevent the battery identifier collision.
- No flash/hardware accuracy claim. Previous SDK-blocked notes below are historical.
- Install the corrected Android APK with this firmware for AA58 timing support.
```

```text
Task: E003
Date: 2026-11-05
Status: Interim implementation / hardware qualification pending; no completion tick
Changed files:
- esp_sensor/main/main.c and imu_transport.h; tests/test_imu_transport.c
- esp_sensor/TIMING_PROTOCOL.md and STREAM_DIAGNOSTICS.md
- Electrophy_app: AcquisitionTimeline.kt, PacketDecoder.kt, DataModels.kt,
  MainActivity.kt, ExperimentScreen.kt, NewtonsThirdLawScreen.kt
- Electrophy_app/app/src/test/java/com/example/electrophy_app/AcquisitionTimelineTest.kt
Behavior changed:
- Negotiated AA58/v2 single-sensor FIFO packets carry boot/segment identity,
  acquired-sample index, first sample device time, period, and timing validity.
- FIFO clock is reconstructed from one monotonic ESP/FIFO-level anchor per segment
  and selected/factory-corrected ODR. Timing uncertainty and oscillator drift are
  explicit: this is not a verified sensor-timestamp implementation.
- Local MTU/queue drops preserve acquisition indices. FIFO faults establish a new
  segment with unknown-loss metadata. Android rejects duplicate/reordered or
  inconsistent timing and does not stretch later samples across missing intervals.
- AxisPoint retains Long nanoseconds and identity through calibration/filtering;
  chart Float time is relative only. Live history restarts at discontinuities,
  with visible counters, until saved interval ownership is integrated under E011.
- v2 gyro integration uses sample time; legacy timing is visibly estimated.
  Old apps retain v1; old firmware/combined modes remain visibly legacy.
- Reset/segment/disconnect invalidates pending trigger callbacks; incoming data
  from an old GATT object is ignored. E010/E019 still have their broader open scope.
- Added two-second TIMING firmware and E003 Logcat summaries plus a v1/v2 comparison
  switch under Stream diagnostics. No per-sample serial logging or hardware flash.
Regression tests and actual results:
- Android testDebugUnitTest (55 tests, zero failures/errors) and assembleDebug passed with installed Android Studio
  JBR; timing tests cover RAW16/packed12, exact header length, malformed packets,
  sample counter wrap, long uptime, missing intervals, duplicate/reorder rejection,
  boot/segment/reset boundaries, unknown upstream loss, and delivery/batch invariance.
- Firmware transport test source cross-compiled with -std=c11 -Wall -Wextra -Werror;
  shared wire size/offset static assertions passed. Cross-compilation does not
  execute native runtime assertions.
Android/firmware build result:
- Debug APK built. lintDebug cannot complete: installed Java 25 triggers the old
  lint Kotlin runtime's Java-version parsing failure (25.0.3). No lint pass claimed.
- Production firmware build cannot configure with the only installed ESP-IDF 5.1.2:
  missing esp_driver_spi (project requires 5.3.1). No production firmware pass claimed.
- An isolated 5.1.2 compatibility project also compiled the production C sources:
  compiler errors were the existing ADC_ATTEN_DB_12 and BLE data-length event APIs
  absent from that SDK. No new timing-code diagnostics were reported, but this is
  not a linked firmware build or a substitute for a 5.3.1 build.
Hardware/UI verification:
- Not performed; no device flashed. Follow TIMING_PROTOCOL.md for paired legacy/v2
  3840/7680 Hz runs, capture TIMING/PERF/FIFO/STREAM and phone E003 lines.
Remaining limitations:
- E004 combined-mode freshness/synchronization; E007 applied configuration;
  E011 immutable captures; E012 downstream timestamp-based math; E017 full attitude.
- Measure acquisition timing uncertainty/drift and actual throughput before calling
  E003 fully qualified. Firmware v2 header is 36 bytes versus v1's 9, so include
  packet/header bandwidth in the comparison rather than assuming negligible overhead.
```

```text
Task: E001
Status: Complete
Changed files:
- Electrophy_app/app/src/main/java/com/example/electrophy_app/SensorConversion.kt (created)
- Electrophy_app/app/src/main/java/com/example/electrophy_app/MainActivity.kt
- .agents/skills/electrophy/SKILL.md
- Electrophy_app/app/src/test/java/com/example/electrophy_app/SensorConversionTest.kt (created)
- ELECTROPHY_APP_AUDIT_AND_IMPLEMENTATION_PLAN.md
Behavior changed:
- Centralized Low-G, High-G, and Gyro sensitivities in pure SensorConversion utility based on official ST LSM6DSV320X register driver constants.
- Corrected High-G sensitivities to [0.000976, 0.001952, 0.003904, 0.007808, 0.010417] g/LSB (resolving ~6.26% underreporting at ±320g).
- Preserved legacy packed12 factor of 16.
- Added explicit rejection and warning logs for unknown/unsupported range IDs.
- Corrected skill documentation table.
Regression tests and actual results:
- SensorConversionTest (7 tests, 100% pass via JUnit 4.13.2 / Kotlin 2.3.10 / JRE 25):
  * acceptanceCriterion_packedValue600At320gIs100g: code 600 at ±320g packed12 yields 100.0032 g (verified != 93.744 g).
  * highGSensitivities_matchOfficialSTDriver: all 5 High-G ranges verified.
  * highGFormats_raw16AndPacked12: verified 16x scaling between raw16 and packed12.
  * lowGSensitivities_matchOfficialSTDriver: verified all 4 Low-G ranges.
  * gyroSensitivities_matchOfficialSTDriver: verified all 6 Gyro ranges.
  * boundaryAndNegativeValues_areSymmetric: verified full signed ranges and negation symmetry.
  * unknownRangeIDs_areRejected: verified rejection of invalid range codes.
Android/firmware build result:
- Standalone JVM compile and JUnit test runner passed. Full Gradle task deferred to E039.
Hardware/UI verification performed (or explicitly not performed):
- Explicitly not performed (pure mathematical conversion & protocol parsing task).
Remaining limitations and follow-up task IDs:
- E002/E003 needed for packet framing, MTU sizing, and hardware timekeeping.
```

```text
Task: E005
Status: Complete
Changed files:
- Electrophy_app/app/src/main/java/com/example/electrophy_app/DataModels.kt (created pure domain models)
- Electrophy_app/app/src/main/java/com/example/electrophy_app/MathEngine.kt
- Electrophy_app/app/src/main/java/com/example/electrophy_app/MathVisualization.kt
- Electrophy_app/app/src/main/java/com/example/electrophy_app/MainActivity.kt
- Electrophy_app/app/src/test/java/com/example/electrophy_app/MedianFilterTest.kt (created)
- ELECTROPHY_APP_AUDIT_AND_IMPLEMENTATION_PLAN.md
Behavior changed:
- Added normalizeMedianWindow in MathEngine to normalize requested median window sizes to centered odd integers in [3, 51] (e.g. 12 -> 13).
- Fixed scratch array allocation and boundary bounds in applyMedianFilter so writing 2*(w/2)+1 elements never overflows the buffer.
- Added deliberate mathematical median handling for clipped boundary windows: odd population returns exact middle element; even population averages the two middle elements.
- Updated MathVisualization default filterLabWindow from 12 to 11.
- Updated MathVisualization slider UI to display the effective odd window size for Median mode so UI labels and engine state agree.
Regression tests and actual results:
- MedianFilterTest (8 tests, 100% pass via JUnit 4.13.2 / Kotlin 2.3.10 / JRE 25):
  * evenWindowSize_doesNotCrash_reproducesAuditProbe: windowSize=12 with 15 samples runs without crash, produces correct median 8.0.
  * everySelectableWindowSize_runsWithoutCrash: tested sizes 1 through 65 across small and large signals.
  * emptyAndShortInput_handledSafely: empty list, 1 sample, and 2 samples handled without crash.
  * largerThanInputWindows_handledSafely: window 31 on 3 samples handled correctly.
  * constantSignal_preservesValues: verified constant signal preservation.
  * rampSignal_computesExpectedMedians: linear ramp verified on interior and averaged edge medians.
  * isolatedImpulse_isCompletelyRejected: single 100g impulse completely rejected to 0.0g.
  * windowNormalization_effectiveSizeAgreement: verified normalization across full range.
- Full suite (SensorConversionTest + MedianFilterTest): 15 tests, 100% pass.
Android/firmware build result:
- Standalone JVM compile and JUnit test runner passed. Full Gradle task deferred to E039.
Hardware/UI verification performed (or explicitly not performed):
- Explicitly not performed (pure mathematical algorithm and UI control alignment).
Remaining limitations and follow-up task IDs:
- E025 for filter cutoff calculations and frequency response labels.
```

```
Task: E002
Date: 2026-10-11
Files modified/created:
- esp_sensor/main/main.c
- Electrophy_app/app/src/main/java/com/example/electrophy_app/PacketDecoder.kt
- Electrophy_app/app/src/main/java/com/example/electrophy_app/MainActivity.kt
- Electrophy_app/app/src/test/java/com/example/electrophy_app/PacketDecoderTest.kt
- ELECTROPHY_APP_AUDIT_AND_IMPLEMENTATION_PLAN.md
Behavior changed:
- Firmware: Added s_negotiated_mtu tracking (defaults to 23 on connect/disconnect, updated on BLE_GAP_EVENT_MTU).
- Firmware: Batch accumulation and flushing strictly limited to min(512, s_negotiated_mtu - 3) via imu_get_max_packet_bytes(). Samples safely dropped when MTU is too small for a full tuple (e.g. ALL mode at MTU 23) rather than transmitting over-the-air truncated packets.
- App: Created PacketDecoder with StrictBitReader. Validates magic (0xAA 0x55), stream mode (0..4), format (0..1), active sensor range codes, and exact required byte lengths before producing any samples.
- App: StrictBitReader throws IllegalArgumentException on bit exhaustion instead of returning 0 (eliminating manufactured fake zero-g samples).
- App: Integrated PacketDecoder.decode into MainActivity.processBinaryPacket; invalid frames are dropped and logged without affecting timekeeping, filters, charts, triggers, or recording.
- App: Bounded pendingData text log accumulation in appendLog to 4096 chars to prevent unbounded memory growth on malformed/non-newline streams.
Regression tests and actual results:
- PacketDecoderTest (8 tests, 100% pass via JUnit 4.13.2 / Kotlin 2.3.10 / JRE 25):
  * testValidRaw16_allModes: validated RAW16 decoding and sensitivity scaling across LOW_ACC, HIGH_ACC, BOTH_ACC, ONLY_GYRO, and ALL.
  * testValidPacked12_allModes_withNegativeValues: verified PACKED12 decoding and 12-bit two's complement sign extension.
  * testOddPackedSampleCounts: verified odd packed sample counts (1, 3, 7 samples) with bit-exact byte boundaries.
  * testMtuBoundaries_mtu23_185_247_517: verified strict packet fitting and truncation rejection at ATT MTUs 23, 185, 247, and 517.
  * testTruncationBoundaries_neverEmitsSamples: tested every truncation length from 0 to requiredBytes - 1; all safely return DecodeResult.Error.
  * testInvalidHeadersAndRangeCodes: rejected bad magic, 0 sample count, unknown mode, unknown format, and invalid range IDs.
  * testRandomGarbageFuzz: verified 500 random payload fuzz iterations never throw unhandled exceptions.
  * testStrictBitReader_exhaustionThrows: verified StrictBitReader bit exhaustion throws exception.
- Full suite (SensorConversionTest + MedianFilterTest + PacketDecoderTest): 23 tests, 100% pass.
Android/firmware build result:
- Standalone JVM compile and JUnit test runner passed. Full Gradle task deferred to E039.
Hardware/UI verification performed (or explicitly not performed):
- Explicitly not performed (firmware code inspected and updated; protocol decoding verified via paired encoder/decoder unit tests).
Remaining limitations and follow-up task IDs:
- E003 for acquisition timestamps, session counters, and explicit packet gaps.
- E004 for hardware FIFO-based sensor synchronization.
```

```
Task: E011
Date: 2026-10-11
Status: Partial (corrected by source reconciliation on 2026-11-05; original completion claim superseded)
Files modified/created:
- Electrophy_app/app/src/main/java/com/example/electrophy_app/CaptureModels.kt
- Electrophy_app/app/src/main/java/com/example/electrophy_app/ChartDecimator.kt
- Electrophy_app/app/src/main/java/com/example/electrophy_app/SmoothAxisScaler.kt
- Electrophy_app/app/src/main/java/com/example/electrophy_app/MainActivity.kt
- Electrophy_app/app/src/main/java/com/example/electrophy_app/ExperimentScreen.kt
- Electrophy_app/app/src/test/java/com/example/electrophy_app/CaptureAndDecimatorTest.kt
- ELECTROPHY_APP_AUDIT_AND_IMPLEMENTATION_PLAN.md
Behavior changed:
- Created DurationBoundedBuffer in CaptureModels.kt retaining at least 35 seconds of continuous streaming history across all ODRs (50 Hz up to multi-kHz) with a 50,000-sample safety cap. Prevents curve erasure on large time windows like 30s.
- Created ChartDecimator.kt implementing peak-preserving min-max decimation downsampling point collections to 2000 points for 60 FPS MPAndroidChart rendering while 100% preserving transient spikes and impacts.
- Created SmoothAxisScaler.kt implementing asymmetric auto-scaling with hysteresis (expandAlpha = 0.60f, contractAlpha = 0.02f, paddingPercent = 0.12f). Eliminates chart curve vibration / flickering caused by instantaneous Y-axis snapping when points roll off the visible viewport.
- Integrated DurationBoundedBuffer, ChartDecimator, and SmoothAxisScaler into MainActivity.kt (SensorChart) and ExperimentScreen.kt (ExperimentChart).
- Created explicit MeasurementCapture and CaptureQualityFlag models in CaptureModels.kt. Captures freeze points, trigger timestamp, and pre-event baseline, guaranteeing that subsequent live chart streaming or point eviction never alters saved capture metrics or integrals.
- Updated ExperimentScreen.kt real-time analysis card to analyze the active visible viewport interval rather than an unbounded floating buffer, supporting fixedBaseline in calculateImpulse and estimateVelocityChange.
Regression tests and actual results:
- CaptureAndDecimatorTest (9 tests, 100% pass via JUnit 4.13.2 / Kotlin 2.3.10 / JRE 25):
  * testDurationBoundedBuffer_retainsAtLeast35Seconds_atMultipleODRs: verified buffer retains >= 35,000 ms at 50, 120, 240, 480, and 1000 Hz, fully supporting 30s viewport.
  * testDurationBoundedBuffer_respectsSafetyMaxPointsCap: verified truncation at max safety point limit.
  * testChartDecimator_preservesIsolatedPeakImpulse: verified isolated 50g spike in 10,000 samples is 100% preserved in decimated output with strictly monotonic timestamps.
  * testChartDecimator_smallListsReturnedUntouched: verified small lists pass through untouched.
  * testMeasurementCapture_frozenImmutability_resistsBufferEviction: verified captured interval, baseline, and integral remain completely unchanged after sliding buffer evicts the captured time span.
  * testMeasurementCapture_qualityFlags: verified INCOMPLETE_ENDPOINT detection.
  * testSmoothAxisScaler_initializationAndPadding: verified 10% padding headroom above/below data range.
  * testSmoothAxisScaler_asymmetricAdaptation_preventsFlickerOnPointExit: verified slow contract (<2% change per frame) prevents curve vibration when points roll off, while spike expand is fast (60%).
  * testSmoothAxisScaler_immediateMode_and_reset: verified immediate snapping during pause and clean state reset on unpause.
- Full suite (CaptureAndDecimatorTest + PacketDecoderTest + SensorConversionTest + MedianFilterTest): 32 tests, 100% pass.
Android/firmware build result:
- Gradle build and unit test runner passed (./gradlew.bat compileDebugKotlin, testDebugUnitTest).
Hardware/UI verification performed (or explicitly not performed):
- Explicitly not performed (algorithm, data model, and chart pipeline verified via JUnit test fixtures).
Remaining limitations and follow-up task IDs:
- E012 for signal alignment before math and actual time intervals in calculus.
- E013 for physical force/impulse mass scaling in SI units.
```

```
Task: E006
Date: 2026-11-06
Status: Complete
Files modified/created:
- Electrophy_app/app/src/main/java/com/example/electrophy_app/MathEngine.kt
- Electrophy_app/app/src/test/java/com/example/electrophy_app/ComparatorTest.kt
- ELECTROPHY_APP_AUDIT_AND_IMPLEMENTATION_PLAN.md
Behavior changed:
- Repaired signal comparator cross-correlation algorithm, optimal lag detection, and phase estimation in MathEngine.compareSignals.
- Replaced defective initialization (`bestCorr = -2f` with `abs(c) > abs(bestCorr)` condition that prevented lag updates and forced peak = -1f).
- Implemented exact overlap Pearson cross-correlation bounded within [-1.0, +1.0] across lag window [-maxLag, +maxLag].
- Safe handling for constant/flat signals (`std < 1e-4`): cleanly returns 0 correlation, 0 lag, and null phase without NaN or exceptions.
- Stated ambiguity convention for periodic signals: detects distinct periodic lobes (separated by a drop of >= 0.15), resolves intra-crest noise ripples, and selects the lobe with minimum absolute lag |lag| (in the principal period interval) to avoid multi-cycle alias ambiguity.
- Preserves signed negative polarity for inverted anti-phase signals (reporting e.g. -1.0 peak correlation and positive delay sign in user language where positive lag means B lags A).
- Gates estimated phase shift: only reports phase when dominant periodicity is justified by autocorrelation (confidence >= 0.35); non-periodic broadband signals return null phase.
Regression tests and actual results:
- ComparatorTest (8 tests, 100% pass via JUnit 4.13.2 / Kotlin 2.0.21):
  * testIdenticalSignals_zeroLag_unitCorrelation: verified identical sines report Pearson = 1.0, peak = 1.0, lag = 0.0 ms, phase = 0.0°.
  * testDelayedSineSignal_reproducesAuditProbe_reportsCorrectLagAndPhase: verified 10 Hz sine delayed by 6 samples at 240 Hz reports lag = 25.0 ms, peak = 1.0, phase = 90.0° (reproducing and resolving the audit probe).
  * testLeadingSineSignal_reportsNegativeLagAndPhase: verified leading sine reports lag = -25.0 ms, phase = -90.0°.
  * testInvertedDelayedSignal_preservesNegativePolarity: verified inverted broadband signal reports lag = 50.0 ms and signed peak = -1.0.
  * testNonperiodicBroadbandSignal_delayed_noPhaseReported: verified nonperiodic broadband noise reports true lag (10.0 ms) and null phase.
  * testConstantSignals_returnUnavailable: verified flat signals safely return 0 correlation, 0 lag, and null phase.
  * testShortAndEmptyInput_handledSafely: verified inputs with n < 8 return empty aligned lists safely.
  * testNoisySignals_identifiesTrueLag: verified 5 Hz sine with 10% additive noise resolves periodicity ambiguity to principal lag (+33.33 ms) with peak > 0.85.
- Full Android test suite: 98 tests across 13 test suites, 100% pass.
Android build result:
- Gradle unit test runner passed (./gradlew.bat testDebugUnitTest).
Hardware/UI verification performed (or explicitly not performed):
- Explicitly not performed (algorithm and mathematical properties verified via comprehensive unit tests in ComparatorTest.kt).
Remaining limitations and follow-up task IDs:
- E012 for cross-sensor hardware time alignment and calibration.
```

```
Task: E008
Date: 2026-11-06
Status: Complete
Files modified/created:
- esp_sensor/main/main.c
- ELECTROPHY_APP_AUDIT_AND_IMPLEMENTATION_PLAN.md
Behavior changed:
- Hardened SPI transport write/read operations (`platform_write` and `platform_read`):
  * Enforced length validation (`len <= 64`) returning `ESP_ERR_INVALID_SIZE`.
  * Enforced recursive mutex acquisition with 100 ms timeout returning `ESP_ERR_TIMEOUT`.
  * Ensured SPI CS pin is asserted low before transaction and deasserted high unconditionally on every return/error path.
  * Mutex is unconditionally released on all paths.
  * Clears read destination buffer (`memset(bufp, 0, len)`) on any read failure to prevent copying uninitialized stack/heap memory.
  * Propagates underlying `esp_err_t` return codes up to the ST sensor driver rather than swallowing errors and returning 0.
- Hardened sensor initialization and readiness in `sensor_task`:
  * Implemented bounded retry loop (5 attempts with 20 ms backoff) for `lsm6dsv320x_device_id_get`.
  * Tracked driver return codes across all IMU initialization calls (`lsm6dsv320x_init_set`, `lsm6dsv320x_reset_set`, `lsm6dsv320x_xl_setup`, `lsm6dsv320x_gy_setup`, etc.).
  * If initialization fails at any stage, `sensor_ready` is strictly held `false`, fault state (`s_sensor_fault`) is set, an error is logged, and the task remains in an idle watchdog-feeding loop rather than falsely reporting sensor readiness.
- Implemented runtime bus error tracking and rate-limited bus recovery:
  * Added `s_stats.spi_errors` and `s_stats.bus_recoveries` to track hardware faults.
  * Added `s_consecutive_read_errors` tracking across FIFO drain (`imu_fifo_drain`) and direct register reads.
  * Added rate-limited (250 ms) bus recovery routine `imu_attempt_bus_recovery()` triggered when consecutive read errors reach 10 (`MAX_CONSECUTIVE_READ_ERRORS`). It resets the SPI bus, verifies WHO_AM_I, and logs recovery status.
- Hardened BLE GATT command interface (`ble_svc_command_access`):
  * Checked ST driver return codes for all accelerometer and gyroscope ODR / full-scale range commands.
  * If the ST driver rejects a configuration (e.g. invalid mode/ODR combination), firmware increments `s_stats.spi_errors`, does not mutate state variables, and returns `BLE_ATT_ERR_UNLIKELY` to the BLE central.
ESP-IDF build result:
- Built with ESP-IDF v6.1 (`idf.py build`): Target esp32c3, 0 warnings, 0 errors, binary size ~910KB.
Android build result:
- Gradle unit test runner passed (./gradlew.bat testDebugUnitTest): 98 tests across 13 test suites, 100% pass.
Hardware/UI verification performed (or explicitly not performed):
- Explicitly not performed on physical target yet (compiled clean; flashing command provided for COM3).
Remaining limitations and follow-up task IDs:
- E007 for atomic applied configuration transactions and configuration ID reporting.
- E009 for BLE transport pacing and sample loss accounting.
```

```
Task: BLE Command Write Reliability and Pause Timeout Fix
Date: 2026-11-06
Status: Complete (Hardware Verified on Dual Devices)
Files modified:
- Electrophy_app/app/src/main/java/com/example/electrophy_app/MainActivity.kt
- esp_sensor/main/main.c
Behavior changed:
- Switched BLE GATT characteristic write type in `processNextCommand()` to `BluetoothGattCharacteristic.WRITE_TYPE_NO_RESPONSE` when `PROPERTY_WRITE_NO_RESPONSE` is available on the RX characteristic. This matches the Nordic UART Service specification and eliminates ATT Write Response (`ATT_WRITE_RSP`) waiting over saturated high-rate streaming links.
- Eliminated spurious 10-second `gattWriteTimeoutRunnable` triggers that were reporting "Bluetooth timed out during pause. Reconnect the device." and disconnecting the peripheral.
- In firmware `esp_sensor/main/main.c`, `imu_chr_access_cb` now calls `imu_discard_pending()` immediately upon receiving "pause" or "stop", cleanly purging `s_tx_queue` and halting outgoing notifications without delay.
- Made `status_led_update_streaming()` and `status_led_tick()` timer stop/start calls non-fatal, preventing `ESP_ERR_INVALID_STATE` panics during rapid state transitions.
Regression tests and build results:
- Android unit tests: 98 tests across 13 test suites, 100% pass (`./gradlew.bat testDebugUnitTest`).
- Android debug APK assembled cleanly (`./gradlew.bat assembleDebug`).
- ESP-IDF v6.1 firmware compiled cleanly and flashed to both devices on COM3 and COM5 with hash verification.
Hardware verification:
- Confirmed resolved on dual hardware devices by user.
```

```
Task: E007
Date: 2026-11-06
Status: Complete
Files modified/created:
- esp_sensor/main/main.c
- Electrophy_app/app/src/main/java/com/example/electrophy_app/SensorConversion.kt
- Electrophy_app/app/src/main/java/com/example/electrophy_app/AppliedConfiguration.kt
- Electrophy_app/app/src/main/java/com/example/electrophy_app/MainActivity.kt
- Electrophy_app/app/src/test/java/com/example/electrophy_app/AppliedConfigurationTest.kt
- ELECTROPHY_APP_AUDIT_AND_IMPLEMENTATION_PLAN.md
Behavior changed:
- Firmware configuration transaction atomicity and batch protection:
  * In `imu_chr_access_cb`, purged pending batches and in-flight TX queues (`imu_discard_pending()`) upon receiving any mode, range, or ODR configuration command while holding `spi_mutex`. This guarantees no partially filled batch from the prior configuration can be appended to or labeled with new metadata.
  * Deferred `s_stream_generation` and monotonic `s_config_id` increment until driver configuration write succeeds (`cmd_rc == 0`).
  * If a driver configuration call fails or an unknown command is received, firmware records `s_stats.spi_errors++`, leaves state variables unchanged, emits `CFG_ERR:<cmd>` notification, and returns `BLE_ATT_ERR_UNLIKELY` to the BLE central.
  * On configuration success, formats `CFG_OK:<cmd> id=<id>` into `latest_ble_str` and notifies the connected central.
  * Ensured range and ODR changes while paused do not restart streaming capture (`g_data_paused` is strictly preserved).
- Valid ODR modes and 1.875 Hz operating mode transition:
  * Implemented low-power mode transition for `odr_low_g_1hz875` using `LSM6DSV320X_XL_LOW_POWER_2_AVG_MD` per AN6119 Table 10 and ST driver restrictions.
  * Configured `LSM6DSV320X_XL_HIGH_PERFORMANCE_MD` for all higher Low-G ODR rates (7.5 Hz to 7.68 kHz) and power-down.
- Android applied vs desired configuration model:
  * Introduced `AppliedConfiguration` data model capturing confirmed hardware mode, Low-G / High-G / Gyro full-scale ranges, ODRs, and configuration ID.
  * Added `getLowGRangeSuffix`, `getHighGRangeSuffix`, `getGyroRangeSuffix`, and `parsePeriodNsToOdrSuffix` to `SensorConversion.kt`.
  * Updated `MainActivity.kt` to update `appliedConfig` directly from verified binary packet headers (AA55 / AA58) and incoming `CFG_OK:` / `CFG_ERR:` responses.
  * Exposed `isConfigurationPending` to distinguish desired UI selections from verified applied sensor hardware state.
  * Reset `appliedConfig.isConfirmed` on Bluetooth disconnection.
Regression tests and build results:
- Android unit tests: 105 tests across 14 test suites, 100% pass (`./gradlew.bat testDebugUnitTest`), including 7 acceptance tests in `AppliedConfigurationTest.kt`.
- Android debug APK assembled cleanly (`./gradlew.bat assembleDebug`).
- ESP-IDF v6.1 firmware compiled with zero errors and flashed to both devices on COM3 and COM5 with hash verification.
Remaining limitations and follow-up task IDs:
- E004 for fresh per-sensor sample tagging and multi-sensor DRDY/FIFO synchronization.
- E009 for BLE transport pacing and loss accounting.
```
