vivekanandRdhakane/electrophy_2/PCB_Project/electrophy_2/ElectroPhy V3 casing.step

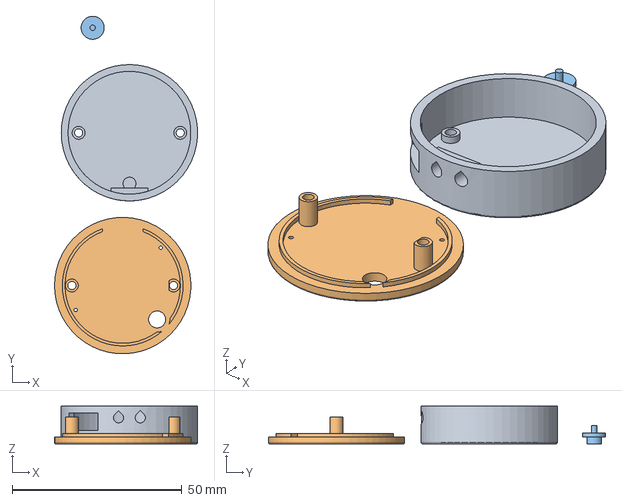
[picture p1: CAD file, 2026-10-21]
PCB_Project/electrophy_2/ElectroPhy V3 casing.step
42.1 x 99.5 x 11.2 mm
