vivekanandRdhakane/electrophy_2/PCB_Project/electrophy_2/LGA-14L_2p5X3X0p83_STM.step

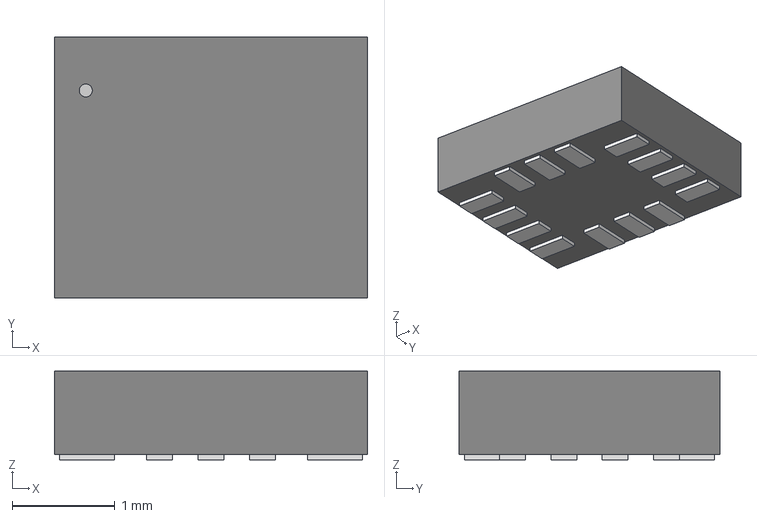
[picture p2: CAD file, 2026-09-21]
PCB_Project/electrophy_2/LGA-14L_2p5X3X0p83_STM.step
3.05 x 2.54 x 0.866 mm
