vivekanandRdhakane/electrophy_2/PCB_Project/electrophy_2/DM-OLED096-636.step

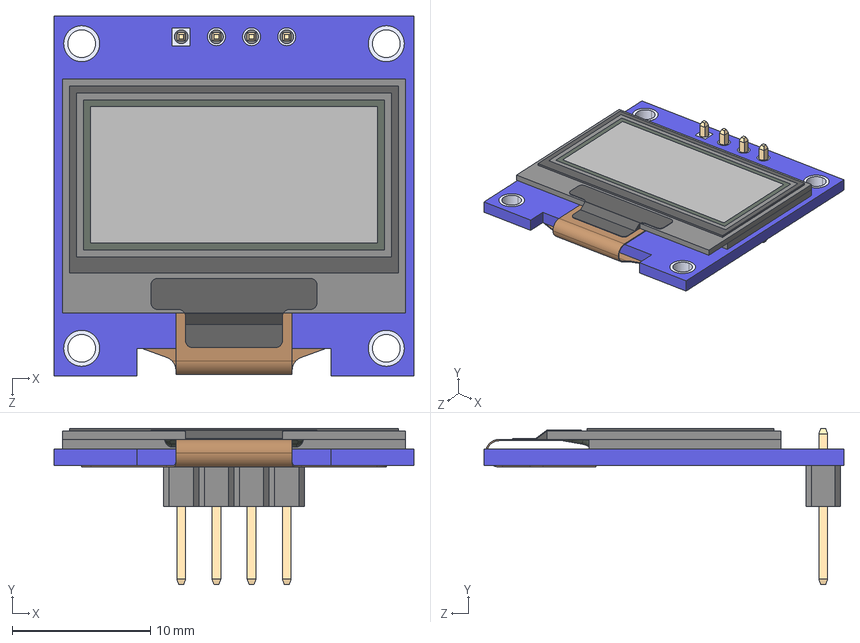
[picture p3: CAD file, 2026-09-21]
PCB_Project/electrophy_2/DM-OLED096-636.step
26.0 x 11.3 x 26.0 mm
DM-OLED096-636_Module
DM-OLED096-636_Panel
