vivekanandRdhakane/electrophy_2/(list of files, cad)

Other CAD files:
PCB_Project/electrophy_2/ElectroPhy V3 casing.3mf
