vivekanandRdhakane/electrophy_2/PCB_Project/electrophy_2/electrophy_2.kicad_pcb

## KiCad design PCB_Project/electrophy_2/electrophy_2.kicad_pcb (2026-10-19)

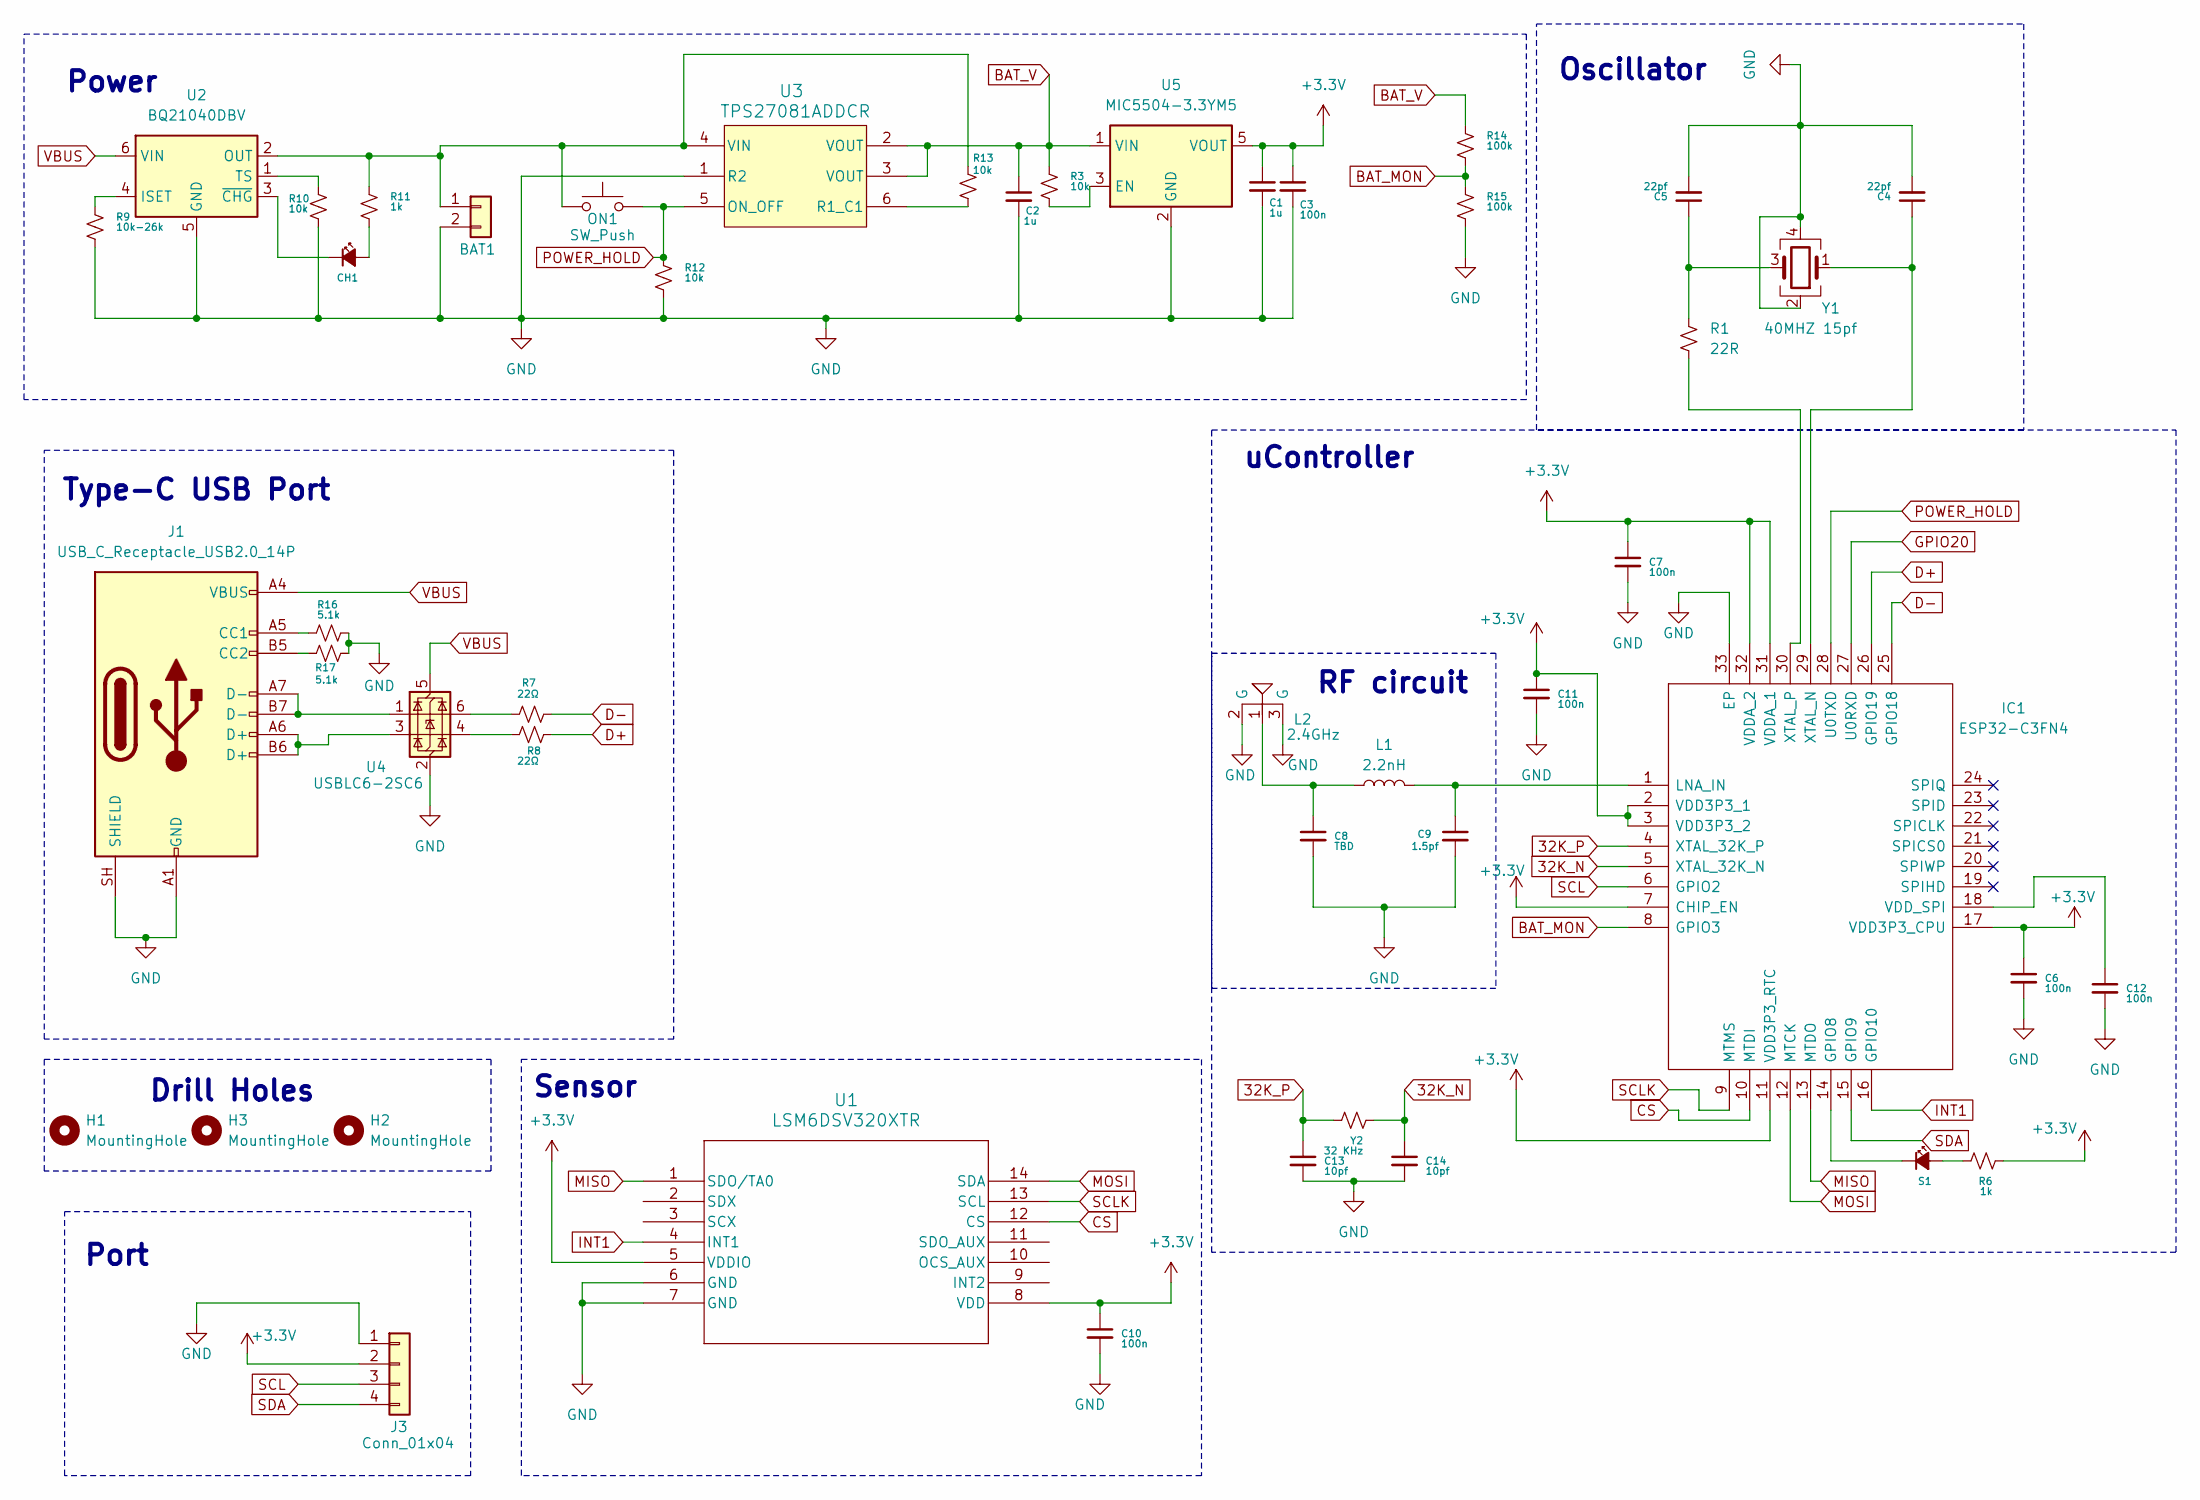
[picture p4: schematic electrophy_2.kicad_sch]

Parts:
BAT1: R_1206_3216Metric
C1, C2: 1u; C_0402_1005Metric_Pad0.74x0.62mm_HandSolder
C3, C6, C7, C10, C11, C12: 100n; C_0402_1005Metric_Pad0.74x0.62mm_HandSolder
C4, C5: 22pf; C_0402_1005Metric_Pad0.74x0.62mm_HandSolder
C8: TBD; C_0402_1005Metric
C9: 1.5pf; C_0402_1005Metric
C13, C14: 10pf; C_0402_1005Metric_Pad0.74x0.62mm_HandSolder
CH1: LED_Small_Filled; LED_0402_1005Metric_Pad0.77x0.64mm_HandSolder
H1: MountingHole; MountingHole_2.2mm_M2_Pad_Via
H2, H3: MountingHole; MountingHole_2.2mm_M2
IC1: ESP32-C3FN4; QFN-32-1EP_5x5mm_P0.5mm_EP3.7x3.7mm; Manufacturer_Part_Number ESP32-C3FN4; Mouser Part Number 356-ESP32-C3FN4
J1: USB_C_Receptacle_USB2.0_14P; USB_C_Receptacle_XKB_U262-16XN-4BVC11
J3: Conn_01x04; pogo_pads_4
L1: 2.2nH; L_0402_1005Metric
L2: 2.4GHz; Chip Antenaa INPAQ ACA-5036-A2-CC-S
ON1: SW_Push; SW_SPST_CK_RS282G05A3
R1: 22R; R_0402_1005Metric_Pad0.72x0.64mm_HandSolder
R3, R10, R12, R13: 10k; R_0402_1005Metric_Pad0.72x0.64mm_HandSolder
R6, R11: 1k; R_0402_1005Metric_Pad0.72x0.64mm_HandSolder
R7, R8: 22Ω; R_0402_1005Metric_Pad0.72x0.64mm_HandSolder
R9: 10k-26k; R_0402_1005Metric_Pad0.72x0.64mm_HandSolder
R14, R15: 100k; R_0402_1005Metric_Pad0.72x0.64mm_HandSolder
R16, R17: 5.1k; R_0402_1005Metric_Pad0.72x0.64mm_HandSolder
S1: LED_Small_Filled; LED_0402_1005Metric_Pad0.77x0.64mm_HandSolder
U1: LSM6DSV320XTR; LGA-14L_2p5X3X0p83_STM
U2: BQ21040DBV; SOT-23-6
U3: TPS27081ADDCR; TPS27081ADDCR_N
U4: USBLC6-2SC6; SOT-23-6
U5: MIC5504-3.3YM5; SOT-23-5
Y1: 40MHZ 15pf; Crystal_SMD_3225-4Pin_3.2x2.5mm
Y2: 32 KHz; R_0402_1005Metric_Pad0.72x0.64mm_HandSolder

Connections:
32K_N: C14.1, IC1.5 (XTAL_32K_N), Y2.2
32K_P: C13.1, IC1.4 (XTAL_32K_P), Y2.1
+3.3V: C1.1, C3.1, C6.1, C7.1, C10.1, C11.1, IC1.2 (VDD3P3_1), IC1.3 (VDD3P3_2), IC1.7 (CHIP_EN), IC1.11 (VDD3P3_RTC), IC1.17 (VDD3P3_CPU), IC1.31 (VDDA_1), IC1.32 (VDDA_2), J3.2, R6.2, U1.5 (VDDIO), U1.8 (VDD), U5.5 (VOUT)
BAT_MON: IC1.8 (GPIO3), R14.2, R15.1
BAT_V: C2.1, R3.1, R14.1, U3.2 (VOUT), U3.3 (VOUT), U5.1 (VIN)
CS: IC1.10 (MTDI), U1.12 (CS)
D+: IC1.26 (GPIO19), R8.2
D-: IC1.25 (GPIO18), R7.2
GND: BAT1.2, C1.2, C2.2, C3.2, C4.2, C5.2, C6.2, C7.2, C8.2, C9.2, C10.2, C11.2, C12.2, C13.2, C14.2, IC1.33 (EP), J1.A1 (GND), J1.A12 (GND), J1.B1 (GND), J1.B12 (GND), J1.SH (SHIELD), J3.1, L2.2 (G), L2.3 (G), R9.2, R10.2, R12.2, R15.2, R16.2, R17.2, U1.6 (GND), U1.7 (GND), U2.5 (GND), U3.1 (R2), U4.2 (GND), U5.2 (GND), Y1.2, Y1.4
GPIO20: IC1.27 (U0RXD)
INT1: IC1.16 (GPIO10), U1.4 (INT1)
MISO: IC1.13 (MTDO), U1.1 (SDO/TA0)
MOSI: IC1.12 (MTCK), U1.14 (SDA)
unnamed: BAT1.1, ON1.1, R11.1, R13.1, U2.2 (OUT), U3.4 (VIN)
unnamed: C5.1, R1.1, Y1.3
unnamed: C8.1, L1.1, L2.1
unnamed: CH1.2 (A), R11.2
unnamed: CH1.1 (K), U2.3 (~CHG)
unnamed: IC1.14 (GPIO8), S1.1 (K)
unnamed: C9.1, IC1.1 (LNA_IN), L1.2
unnamed: C12.1, IC1.18 (VDD_SPI)
unnamed: C4.1, IC1.29 (XTAL_N), Y1.1
unnamed: IC1.30 (XTAL_P), R1.2
unnamed: J1.A5 (CC1), R16.1
unnamed: J1.B5 (CC2), R17.1
unnamed: J1.A6 (D+), J1.B6 (D+), U4.3 (I/O2)
unnamed: J1.A7 (D-), J1.B7 (D-), U4.1 (I/O1)
unnamed: R7.1, U4.6 (I/O1)
unnamed: R8.1, U4.4 (I/O2)
unnamed: R6.1, S1.2 (A)
unnamed: R9.1, U2.4 (ISET)
unnamed: R10.1, U2.1 (TS)
unnamed: R13.2, U3.6 (R1_C1)
unnamed: R3.2, U5.3 (EN)
POWER_HOLD: IC1.28 (U0TXD), ON1.2, R12.1, U3.5 (ON_OFF)
SCL: IC1.6 (GPIO2), J3.3
SCLK: IC1.9 (MTMS), U1.13 (SCL)
SDA: IC1.15 (GPIO9), J3.4
VBUS: J1.A4 (VBUS), J1.A9 (VBUS), J1.B4 (VBUS), J1.B9 (VBUS), U2.6 (VIN), U4.5 (VBUS)

Notes on the sheet:
Type-C USB Port
uController
RF circuit
Power
Drill Holes
Sensor
Port
Oscillator

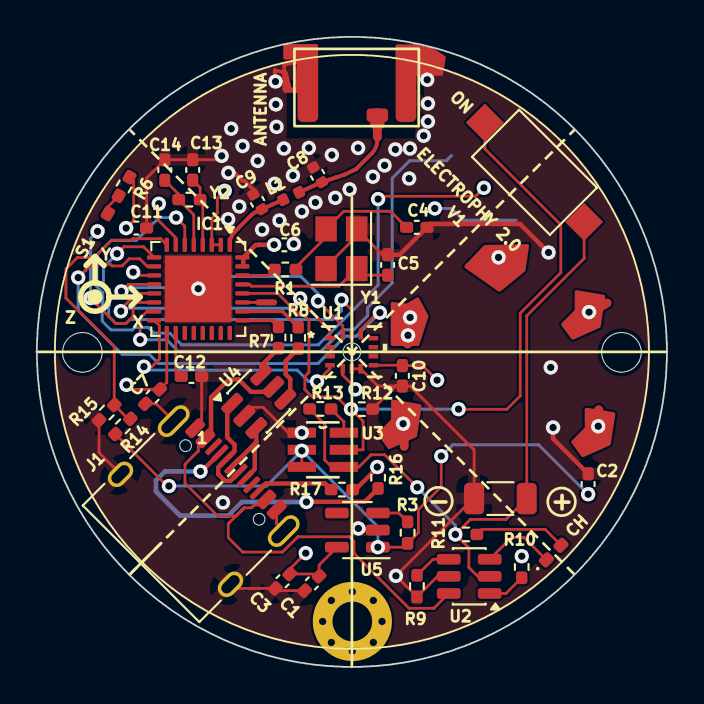
[picture p5: board electrophy_2.kicad_pcb from above]

Board: 4 copper layers, 35.0 x 35.0 mm, 47 parts (1 on the bottom side), 38 nets.
