vivekanandRdhakane/electrophy_2/archived/sensor_nucleo_L552_with_int/sensor_nucleo_L552_with_int.ioc

Mcu.UserName=STM32L552ZETxQ
PB0.GPIO_Label=LSM6DSV320X_INT1
PB0.Signal=GPXTI0
PA1.Signal=SPI1_SCK
PA4.Signal=GPIO_Output
PA6.Signal=SPI1_MISO
PA7.Signal=SPI1_MOSI
PG7.Signal=LPUART1_TX
PG8.Signal=LPUART1_RX
