vivekanandRdhakane/electrophy_2/sensor_nucleo_L552_with_int/Core/Src/main.c

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
/* Includes ------------------------------------------------------------------*/
#include "main.h"

/* USER CODE BEGIN Includes */

#include "lsm6dsv320x_reg.h"
#include <string.h>
/* USER CODE END Includes */


COM_InitTypeDef BspCOMInit;

SPI_HandleTypeDef hspi1;

/* USER CODE BEGIN PV */
float_t temp;
/* Flag set by EXTI0 ISR when LSM6DSV320X INT1 asserts data ready */
volatile uint8_t drdy_flag = 0;
/* USER CODE END PV */

void SystemClock_Config(void);
static void MX_GPIO_Init(void);
static void MX_ICACHE_Init(void);
static void MX_SPI1_Init(void);
/* USER CODE BEGIN 0 */
static int32_t platform_write(void *handle, uint8_t reg, const uint8_t *bufp, uint16_t len)
{
  HAL_GPIO_WritePin(CS_GPIO_PORT, CS_PIN, GPIO_PIN_RESET);
  HAL_SPI_Transmit((SPI_HandleTypeDef*)handle, &reg, 1, 1000);
  HAL_SPI_Transmit((SPI_HandleTypeDef*)handle, (uint8_t*)bufp, len, 1000);
  HAL_GPIO_WritePin(CS_GPIO_PORT, CS_PIN, GPIO_PIN_SET);
  return 0;
}

static int32_t platform_read(void *handle, uint8_t reg, uint8_t *bufp, uint16_t len)
{
  reg |= 0x80; /* Read bit for LSM6DSV320X SPI */
  HAL_GPIO_WritePin(CS_GPIO_PORT, CS_PIN, GPIO_PIN_RESET);
  HAL_SPI_Transmit((SPI_HandleTypeDef*)handle, &reg, 1, 1000);
  HAL_SPI_Receive((SPI_HandleTypeDef*)handle, bufp, len, 1000);
  HAL_GPIO_WritePin(CS_GPIO_PORT, CS_PIN, GPIO_PIN_SET);
  return 0;
}
/* USER CODE END 0 */

/**
  * @brief  The application entry point.
  * @retval int
  */
int main(void)
{

  /* MCU Configuration--------------------------------------------------------*/

  /* Reset of all peripherals, Initializes the Flash interface and the Systick. */
  HAL_Init();

  /* Configure the system clock */
  SystemClock_Config();

  /* Initialize all configured peripherals */
  MX_GPIO_Init();
  MX_ICACHE_Init();
  MX_SPI1_Init();
  /* Initialize leds */
  BSP_LED_Init(LED_GREEN);
  BSP_LED_Init(LED_BLUE);
  BSP_LED_Init(LED_RED);

  /* Initialize USER push-button, will be used to trigger an interrupt each time it's pressed.*/
  BSP_PB_Init(BUTTON_USER, BUTTON_MODE_EXTI);

  /* Initialize COM1 port (115200, 8 bits (7-bit data + 1 stop bit), no parity */
  BspCOMInit.BaudRate   = 115200;
  BspCOMInit.WordLength = COM_WORDLENGTH_8B;
  BspCOMInit.StopBits   = COM_STOPBITS_1;
  BspCOMInit.Parity     = COM_PARITY_NONE;
  BspCOMInit.HwFlowCtl  = COM_HWCONTROL_NONE;
  if (BSP_COM_Init(COM1, &BspCOMInit) != BSP_ERROR_NONE)
  {
    Error_Handler();
  }

  /* Infinite loop */
  /* USER CODE BEGIN WHILE */
  /* Initialize COM1 port (115200, 8 bits (7-bit data + 1 stop bit), no parity */
  BspCOMInit.BaudRate   = 115200;
  BspCOMInit.WordLength = COM_WORDLENGTH_8B;
  BspCOMInit.StopBits   = COM_STOPBITS_1;
  BspCOMInit.Parity     = COM_PARITY_NONE;
  BspCOMInit.HwFlowCtl  = COM_HWCONTROL_NONE;
  if (BSP_COM_Init(COM1, &BspCOMInit) != BSP_ERROR_NONE)
  {
    Error_Handler();
  }
  stmdev_ctx_t dev_ctx;
  uint8_t whoamI;

  dev_ctx.write_reg = platform_write;
  dev_ctx.read_reg = platform_read;
  dev_ctx.mdelay = (void (*)(uint32_t))HAL_Delay;
  dev_ctx.handle = &hspi1;

  HAL_GPIO_WritePin(CS_GPIO_PORT, CS_PIN, GPIO_PIN_RESET);

  /* Wait sensor boot time */
  HAL_Delay(100);
/* Explicitly configure 4-wire SPI mode (SIM = 0 in IF_CFG register 0x03) */
    lsm6dsv320x_spi_mode_set(&dev_ctx, LSM6DSV320X_SPI_4_WIRE);
  /* Check device ID */
  lsm6dsv320x_device_id_get(&dev_ctx, &whoamI);
  if (whoamI != LSM6DSV320X_ID) {
    printf("LSM6DSV320X not found! WHO_AM_I = 0x%02X (expected 0x%02X)\r\n", whoamI, LSM6DSV320X_ID);
    printf("Please verify SPI wiring and that CS is connected to PA4.\r\n");
  } else {
    printf("LSM6DSV320X Found! WHO_AM_I = 0x%02X\r\n", whoamI);

    /* Perform device power-on-reset */
    lsm6dsv320x_sw_por(&dev_ctx);
    HAL_Delay(15);

    /* Enable Block Data Update */
    lsm6dsv320x_block_data_update_set(&dev_ctx, PROPERTY_ENABLE);

    /* Set Output Data Rate for accelerometer and gyroscope */
    lsm6dsv320x_xl_data_rate_set(&dev_ctx, LSM6DSV320X_ODR_AT_15Hz);
    lsm6dsv320x_gy_data_rate_set(&dev_ctx, LSM6DSV320X_ODR_AT_15Hz);

    /* Set full scale */
    lsm6dsv320x_xl_full_scale_set(&dev_ctx, LSM6DSV320X_2g);
    lsm6dsv320x_gy_full_scale_set(&dev_ctx, LSM6DSV320X_2000dps);

    /* Route drdy_xl and drdy_g to INT1 pin so PB0 fires on every new sample */
    lsm6dsv320x_pin_int_route_t pin_int = {0};
    pin_int.drdy_xl = PROPERTY_ENABLE;
    pin_int.drdy_g  = PROPERTY_ENABLE;
    lsm6dsv320x_pin_int1_route_set(&dev_ctx, &pin_int);

    printf("LSM6DSV320X Accelerometer + Gyroscope initialized (interrupt-driven via INT1/PB0).\r\n");
  }
  while (1)
  {

    /* USER CODE END WHILE */

    /* USER CODE BEGIN 3 */
    if (drdy_flag)
    {
      drdy_flag = 0;

      int16_t data_raw_acceleration[3];
      int16_t data_raw_angular_rate[3];
      float acceleration_mg[3];
      float angular_rate_mdps[3];

      memset(data_raw_acceleration, 0x00, 3 * sizeof(int16_t));
      memset(data_raw_angular_rate, 0x00, 3 * sizeof(int16_t));

      lsm6dsv320x_acceleration_raw_get(&dev_ctx, data_raw_acceleration);
      lsm6dsv320x_angular_rate_raw_get(&dev_ctx, data_raw_angular_rate);

      acceleration_mg[0] = lsm6dsv320x_from_fs2_to_mg(data_raw_acceleration[0]);
      acceleration_mg[1] = lsm6dsv320x_from_fs2_to_mg(data_raw_acceleration[1]);
      acceleration_mg[2] = lsm6dsv320x_from_fs2_to_mg(data_raw_acceleration[2]);

      angular_rate_mdps[0] = lsm6dsv320x_from_fs2000_to_mdps(data_raw_angular_rate[0]);
      angular_rate_mdps[1] = lsm6dsv320x_from_fs2000_to_mdps(data_raw_angular_rate[1]);
      angular_rate_mdps[2] = lsm6dsv320x_from_fs2000_to_mdps(data_raw_angular_rate[2]);

      temp = acceleration_mg[2];

      printf("%lu ms\t[mg] X=%0.2f\tY=%0.2f\tZ=%0.2f\t[mdps] X=%0.2f\tY=%0.2f\tZ=%0.2f\r\n",
             (unsigned long)HAL_GetTick(),
             acceleration_mg[0], acceleration_mg[1], acceleration_mg[2],
             angular_rate_mdps[0], angular_rate_mdps[1], angular_rate_mdps[2]);
      BSP_LED_Toggle(LED_GREEN);
    }
    /* No HAL_Delay here — CPU is free; INT1 wakes us when data is ready */
  }
  /* USER CODE END 3 */
}

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
