vivekanandRdhakane/electrophy_2/archived/sensor_nucleo_L552_with_int/Core/Inc/main.h

#define CS_GPIO_PORT GPIOA
#define CS_PIN       GPIO_PIN_4
#define INT1_GPIO_PORT GPIOB
#define INT1_PIN       GPIO_PIN_0
#define INT1_EXTI_IRQn EXTI0_IRQn
