vivekanandRdhakane/electrophy_2/(commit log)

2026-09-08 working SPI
2026-09-11 reading sensor with interrupt
2026-09-12 added esp project to read sensor
2026-09-13 added pause button
2026-09-13 clear for switching
2026-09-13 add slider for buttons
2026-09-13 printed sample rate
2026-09-14 added filter
2026-09-19 moved stm32 archived
2026-09-19 added PCB
    [electrophy_2.kicad_pcb, electrophy_2.kicad_sch]
2026-09-21 PCB draft
    [DM-OLED096-636.step, LGA-14L_2p5X3X0p83_STM.step, electrophy_2.kicad_pcb, electrophy_2.kicad_sch]
2026-09-21 [FIX] ODR not updating from HIGH-G
    [main.c]
2026-09-21 added CC1 and CC2 resistors
    [electrophy_2.kicad_pcb, electrophy_2.kicad_sch]
2026-09-26 order placed for ElectroPhy 2.0 V1 PCB
    [electrophy_2-B_Cu.gbr, electrophy_2-B_Mask.gbr, electrophy_2-B_Paste.gbr, electrophy_2-B_Silkscreen.gbr, electrophy_2-Edge_Cuts.gbr, electrophy_2-F_Cu.gbr, electrophy_2-F_Mask.gbr, electrophy_2-F_Paste.gbr]
2026-09-28 re-uploaded this version because of DFM issue
    [electrophy_2-B_Cu.gbr, electrophy_2-B_Mask.gbr, electrophy_2-B_Paste.gbr, electrophy_2-B_Silkscreen.gbr, electrophy_2-Edge_Cuts.gbr, electrophy_2-F_Cu.gbr, electrophy_2-F_Mask.gbr, electrophy_2-F_Paste.gbr]
2026-10-03 Add zero-drift sensor calibration palette with configurable window
2026-10-03 Fix wing color switching by removing duplicate coplanar faces and tuning lighting
2026-10-03 Normalize yaw heading modulo 360 after rounding so 360 wraps seamlessly to 0
2026-10-03 Make sensor calibration palette collapsible with header toggle and summary text
2026-10-03 Reorder physics experiment categories: Flight & Aerodynamics, then Kinematics, then Mechanics
2026-10-03 Update Newton's Third Law default configuration to 50ms window, 7680Hz ODR, 320g, EMA disabled, and deviation trigger (th=30, delay=30ms)
2026-10-11 fix(math): resolve median filter array-index crash and normalize odd windows (E005)
2026-10-11 feat: implement E002 MTU-aware packets and strict decoding
    - Firmware: Dynamically track negotiated ATT MTU and cap packet payload to min(512, MTU - 3); safely drop batches if payload capacity cannot fit a full sample tuple.
    - Android: Implement strict PacketDecoder with StrictBitReader (rejecting truncated frames, out-of-range sensor IDs, and raising on bit exhaustion instead of returning fake 0s).
    - Android: Wire PacketDecoder into MainActivity and bound log buffer to 4096 chars.
    - Tests: Add paired encoder/decoder unit tests covering all modes, odd sample counts, MTUs 23/185/247/517, truncation boundaries, and garbage rejection.
    - Update ELECTROPHY_APP_AUDIT_AND_IMPLEMENTATION_PLAN.md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
2026-10-11 E011: duration-bounded plot buffer, peak-preserving decimation, and smooth Y-axis scaling
2026-10-19 Add ESP sensor USB debug output and board power controls
2026-10-19 Add three-second USB startup window with steady status LED
2026-10-19 Add BLE inactivity shutdown and steady streaming LED
2026-10-19 Profile sensor acquisition and move stream diagnostics control
2026-10-19 Use hardware FIFO for single-sensor BLE acquisition
2026-10-19 changed Iset resistor value in schematic
2026-10-20 Add battery monitoring, low-voltage shutdown and app charge display
2026-10-20 Calibrate battery percentage from measured discharge runtime
2026-10-31 Add controller and BLE assembly test modes
2026-11-01 Use unique BLE names and select among Electrophy devices
2026-11-01 Support two-device Newton collision experiment
2026-11-06 Keep paired Newton plot live across sample gaps
2026-11-06 Propagate SPI and IMU driver errors in firmware (Task E008)
2026-11-06 feat(newton): add accelerometer range saturation warning and step-up recommendation
2026-11-06 feat(navigation): restore raw data mode defaults when switching from experiments
