vivekanandRdhakane/electrophy_2/(notices)

Notices in the files:
sensor_nucleo_L552_with_int/Core/Src/main.c:
Copyright (c) 2026 STMicroelectronics.
All rights reserved.
This software is licensed under terms that can be found in the LICENSE file
